mvalancy/pcb-agx-thor-can-breakout/docs/README.md

<!-- generated by tools/write_readmes.py -->
# Engineering documentation

[Project overview](../README.md) · [Documentation](README.md) · [Local design review](http://localhost:8765/site/)

Review the interface, inspect the enclosure, and follow the evidence from source to manufacturing package.

Thor CAN enclosure

## Start with your task

| I want to… | Read this | What it answers |
|---|---|---|
| Verify the wiring | [PINOUT proof](pinout-proof.md) | Original NVIDIA excerpts, J47 pins and termination |
| Set up termination / I/O | [Controls and prototyping](termination-and-io.md) | JP shunts, power rails, FSI GPIO limits and free pad area |
| Understand protection | [Interface and protection](interface-and-protection.md) | TVS selection, open links, raw I/O and electrical limits |
| Inspect the housing | [Enclosure design](enclosure.md) | Lid graphics, keyed seam, inserts, clamp and mating clearances |
| Review the latest changes | [Design review](design-review.md) | Routing, fabrication rules and corrected PCB orientation |
| Prepare a prototype quote | [Manufacturing](manufacturing.md) | Gerbers, two BOM/CPL options and supplier review |
| Decide whether to build 50 | [Release checklist](release-checklist.md) | Tests and procurement evidence still needed |
| Reproduce the work | [Tools guide](../tools/README.md) | Safe export, verification and packaging sequence |

## Evidence and history

[Iteration register](iterations.md) records findings and corrections. [Progress log](progress.md) preserves the development history; its earlier entries describe superseded designs. [Decisions](decisions.yaml) and [milestones](milestones.yaml) feed the local status page.

The current design is **A1, under engineering review**. Native CAD passes do not close physical qualification. A0 downloads are historical and superseded.

<details>
<summary>Complete folder index</summary>

| File or folder | Purpose |
|---|---|
| [img/](img/README.md) | Documentation images |
| [proof/](proof/README.md) | NVIDIA pinout evidence |
| [cad-agent-report.html](cad-agent-report.html) | Project support file |
| [decisions.yaml](decisions.yaml) | Project status/configuration |
| [design-review.md](design-review.md) | Design review — 2026-10-26 |
| [enclosure.md](enclosure.md) | Enclosure design |
| [interface-and-protection.md](interface-and-protection.md) | Interface and protection review |
| [iterations.md](iterations.md) | Iterations and validation evidence |
| [manufacturing.md](manufacturing.md) | Manufacturing and 50-unit plan |
| [milestones.yaml](milestones.yaml) | Project status/configuration |
| [pinout-proof.md](pinout-proof.md) | PINOUT proof |
| [progress.md](progress.md) | Progress log |
| [release-checklist.md](release-checklist.md) | Release checklist |
| [termination-and-io.md](termination-and-io.md) | Termination, power and prototyping |

</details>
