mvalancy/pcb-agx-thor-can-breakout/exports/README.md

<!-- generated by tools/write_readmes.py -->
# Design downloads

[Project overview](../README.md) · [Documentation](../docs/README.md) · [Local design review](http://localhost:8765/site/)

Reviewable electrical packages, printable housing parts and source-bound validation evidence.

Assembled product

## Select your package

| Deliverable | Start here | Contents |
|---|---|---|
| Two-port electronics | [2-port files](2port/README.md) | Native exports, fabrication ZIP, BOM/CPL and reports |
| Four-port electronics | [4-port files](4port/README.md) | Reserved-channel engineering variant |
| Printed housing | Matching `2port_` or `4port_` base/lid | STL, 3MF and STEP; add one common ribbon clamp |
| Fit coupons | [Fastener](fastener_coupon.stl) · [DE9 opening](port_coupon.stl) | Print before committing to a full housing |
| Hardware | [Enclosure BOM](enclosure-bom.csv) | Inserts, screws, silicone pads and mating references |
| Browser assembly | [Viewer data](view/README.md) | Shared cad-agent scenes and downloadable meshes |

Print only the matching base/lid pair plus `ribbon_clamp`. STL and 3MF use print orientation; STEP uses assembly coordinates. `asm_*` files are assembly references, not a print list.

Follow the [assembly guide](../ASSEMBLY.md) and [manufacturing guide](../docs/manufacturing.md). These A1 files are engineering review artifacts; supplier DFM and physical qualification remain open.

<details>
<summary>Complete folder index</summary>

| File or folder | Purpose |
|---|---|
| [2port/](2port/README.md) | 2-port design package |
| [4port/](4port/README.md) | 4-port design package |
| [view/](view/README.md) | Interactive assembly data |
| [2port_base.3mf](2port_base.3mf) | Bed-oriented print mesh and units |
| [2port_base.step](2port_base.step) | Solid model in assembly coordinates |
| [2port_base.stl](2port_base.stl) | Bed-oriented print mesh |
| [2port_lid.3mf](2port_lid.3mf) | Bed-oriented print mesh and units |
| [2port_lid.step](2port_lid.step) | Solid model in assembly coordinates |
| [2port_lid.stl](2port_lid.stl) | Bed-oriented print mesh |
| [4port_base.3mf](4port_base.3mf) | Bed-oriented print mesh and units |
| [4port_base.step](4port_base.step) | Solid model in assembly coordinates |
| [4port_base.stl](4port_base.stl) | Bed-oriented print mesh |
| [4port_lid.3mf](4port_lid.3mf) | Bed-oriented print mesh and units |
| [4port_lid.step](4port_lid.step) | Solid model in assembly coordinates |
| [4port_lid.stl](4port_lid.stl) | Bed-oriented print mesh |
| [asm_2port_can_cables.step](asm_2port_can_cables.step) | Solid model in assembly coordinates |
| [asm_2port_clamp.step](asm_2port_clamp.step) | Solid model in assembly coordinates |
| [asm_2port_female.step](asm_2port_female.step) | Solid model in assembly coordinates |
| [asm_2port_header.step](asm_2port_header.step) | Solid model in assembly coordinates |
| [asm_2port_hoods.step](asm_2port_hoods.step) | Solid model in assembly coordinates |
| [asm_2port_inserts.step](asm_2port_inserts.step) | Solid model in assembly coordinates |
| [asm_2port_legend_paint.step](asm_2port_legend_paint.step) | Solid model in assembly coordinates |
| [asm_2port_pcb.step](asm_2port_pcb.step) | Solid model in assembly coordinates |
| [asm_2port_ribbon.step](asm_2port_ribbon.step) | Solid model in assembly coordinates |
| [asm_2port_screws.step](asm_2port_screws.step) | Solid model in assembly coordinates |
| [asm_2port_thumbscrews.step](asm_2port_thumbscrews.step) | Solid model in assembly coordinates |
| [asm_4port_can_cables.step](asm_4port_can_cables.step) | Solid model in assembly coordinates |
| [asm_4port_clamp.step](asm_4port_clamp.step) | Solid model in assembly coordinates |
| [asm_4port_female.step](asm_4port_female.step) | Solid model in assembly coordinates |
| [asm_4port_header.step](asm_4port_header.step) | Solid model in assembly coordinates |
| [asm_4port_hoods.step](asm_4port_hoods.step) | Solid model in assembly coordinates |
| [asm_4port_inserts.step](asm_4port_inserts.step) | Solid model in assembly coordinates |
| [asm_4port_legend_paint.step](asm_4port_legend_paint.step) | Solid model in assembly coordinates |
| [asm_4port_pcb.step](asm_4port_pcb.step) | Solid model in assembly coordinates |
| [asm_4port_ribbon.step](asm_4port_ribbon.step) | Solid model in assembly coordinates |
| [asm_4port_screws.step](asm_4port_screws.step) | Solid model in assembly coordinates |
| [asm_4port_thumbscrews.step](asm_4port_thumbscrews.step) | Solid model in assembly coordinates |
| [cad-agent-results.json](cad-agent-results.json) | Machine-readable design evidence |
| [designs.json](designs.json) | Machine-readable design evidence |
| [enclosure-bom.csv](enclosure-bom.csv) | Assembly or sourcing table |
| [fastener_coupon.3mf](fastener_coupon.3mf) | Bed-oriented print mesh and units |
| [fastener_coupon.step](fastener_coupon.step) | Solid model in assembly coordinates |
| [fastener_coupon.stl](fastener_coupon.stl) | Bed-oriented print mesh |
| [geometry-checks.json](geometry-checks.json) | Printable solid and mesh evidence |
| [hole-checks.json](hole-checks.json) | Every hole and countersink clear of material, bound to each STEP |
| [inserts.json](inserts.json) | M3 heat-set insert joints: capacities and torque ceiling |
| [overhang-screen.json](overhang-screen.json) | Downward-facing regions flatter than the overhang limit |
| [pcb-agx-thor-can-breakout-plates.3mf](pcb-agx-thor-can-breakout-plates.3mf) | Bed-oriented print mesh and units |
| [pcb-agx-thor-can-breakout-plates.json](pcb-agx-thor-can-breakout-plates.json) | Machine-readable design evidence |
| [pcb-agx-thor-can-breakout-plates.svg](pcb-agx-thor-can-breakout-plates.svg) | Scalable drawing |
| [port_coupon.3mf](port_coupon.3mf) | Bed-oriented print mesh and units |
| [port_coupon.step](port_coupon.step) | Solid model in assembly coordinates |
| [port_coupon.stl](port_coupon.stl) | Bed-oriented print mesh |
| [review.json](review.json) | Machine-readable design evidence |
| [ribbon_clamp.3mf](ribbon_clamp.3mf) | Bed-oriented print mesh and units |
| [ribbon_clamp.step](ribbon_clamp.step) | Solid model in assembly coordinates |
| [ribbon_clamp.stl](ribbon_clamp.stl) | Bed-oriented print mesh |
| [slice-report.json](slice-report.json) | Shared cad-agent slicing estimates and 3MF hashes for every printed part |

</details>
