mvalancy/pcb-agx-thor-can-breakout/tools/README.md

<!-- generated by tools/write_readmes.py -->
# Build and validation tools

[Project overview](../README.md) · [Documentation](../docs/README.md) · [Local design review](http://localhost:8765/site/)

Reproduce the committed design without silently replacing the reviewed routing.

## Rebuild the committed boards

Run from the repository root. `kicad-cli` must be on PATH. The commands marked `KiCad-Python` require the interpreter that provides `pcbnew`; the project venv supplies CadQuery and cad-agent.

```bash
.venv/bin/python tools/export_review.py
KiCad-Python tools/check_can_routing.py
KiCad-Python tools/check_fabrication.py
KiCad-Python tools/check_prototype.py
.venv/bin/python tools/check_electronics.py
.venv/bin/python cad/build.py
.venv/bin/python tools/check_mechanics.py
.venv/bin/python tools/check_lid_markings.py
.venv/bin/python tools/render_review.py
.venv/bin/python tools/draw_mechanics.py
.venv/bin/python tools/draw_controls.py
.venv/bin/cad-agent export-3mf
.venv/bin/cad-agent slice
.venv/bin/python tools/check_lid_slicing.py
.venv/bin/cad-agent view
.venv/bin/python tools/update_evidence.py
.venv/bin/cad-agent report
.venv/bin/python tools/write_readmes.py
.venv/bin/python tools/validate_release.py --record
.venv/bin/python tools/package_release.py
```

`KiCad-Python` above is a placeholder for your KiCad Python executable, not an installed command. Native exports refill and save the board before generating reports. Complete source-changing steps before recording hashes. For a schematic drawing-only adjustment, `export_review.py --schematic-only` regenerates ERC/PDF/netlist and checks parity without changing the board or its STEP.

## Recheck the slicing and printability

With Bambu Studio installed, run `.venv/bin/cad-agent slice`, followed by `.venv/bin/python tools/check_lid_slicing.py`. The shared slicer resolves preset inheritance, runs the offline slices and binds the report to the 3MF hashes. `cad-agent.yaml` lists all seven printed parts (both lids and bases, the ribbon clamp and both coupons), so `exports/slice-report.json` holds a slice, mass and time for each. The project checker then verifies the lids' effective P1S/PETG/nozzle/layer settings and adds actual first-layer SVGs. Vendor presets, sliced projects and G-code stay in ignored `build/slicer/`; no printer is contacted. A successful slice is not a print qualification.

Before a release, also run `.venv/bin/cad-agent holes` (every hole and countersink in each STEP is clear of material: `exports/hole-checks.json`), `.venv/bin/cad-agent overhangs` (downward faces flatter than the limit: `exports/overhang-screen.json`) and `.venv/bin/cad-agent inserts cad/joints.yaml --output exports/inserts.json` (torque ceiling for the M3 insert joints).

## When changing the circuit or routing

`build_electronics.py` overwrites native layouts unless passed `--schematic-only`. Full regeneration includes `update_layout_features.py` for board outline, prototype grids and legends. Export the schematic netlist, then use paired CAN seeds (`route_can_pairs.py`), auxiliary routing (`route_boards.py`), net/zone finalization (`finalize_board.py`), and every electrical check. Read their module documentation before invoking them. Never accept a router exit code as connectivity proof.

| Check | Evidence |
|---|---|
| Native ERC/DRC and parity | KiCad report JSON, including unconnected items |
| `check_electronics.py` | Independent 26-pin source transcription, DE9/TVS/links and BOM/CPL |
| `check_can_routing.py` | H/L path, pair gap, skew, TVS placement and sampled return plane |
| `check_fabrication.py` | JLC-derived feature limits and deliberate native-rule negative control |
| `check_prototype.py` | Isolated pad count/pitch, ribbon exclusion, gated power mapping and bare-pad assembly exclusions |
| `check_mechanics.py` | Assembly insertion paths from exported solids |
| `check_lid_markings.py` | Native glyph-to-artwork, roof edge and counterbore clearances |
| `check_lid_slicing.py` | Offline lid-only Bambu slicing and actual first-layer toolpath proofs |
| `validate_release.py` | Fresh hashes, source reports, printable meshes, 3MF and local links |

Shared geometry, panel markings, routing analysis, reports, site navigation and 3D viewing come from the pinned **cad-agent** dependency. Project scripts hold only Thor-specific dimensions, mapping and workflow. No automated check establishes physical fit, EMC or a supported bitrate.

<details>
<summary>Complete folder index</summary>

| File or folder | Purpose |
|---|---|
| [apply_fab_rules.py](apply_fab_rules.py) | Generation or validation tool |
| [build_electronics.py](build_electronics.py) | Generation or validation tool |
| [check_can_routing.py](check_can_routing.py) | Generation or validation tool |
| [check_electronics.py](check_electronics.py) | Generation or validation tool |
| [check_fabrication.py](check_fabrication.py) | Generation or validation tool |
| [check_lid_markings.py](check_lid_markings.py) | Generation or validation tool |
| [check_lid_slicing.py](check_lid_slicing.py) | Generation or validation tool |
| [check_mechanics.py](check_mechanics.py) | Generation or validation tool |
| [check_prototype.py](check_prototype.py) | Generation or validation tool |
| [draw_controls.py](draw_controls.py) | Generation or validation tool |
| [draw_mechanics.py](draw_mechanics.py) | Generation or validation tool |
| [export_review.py](export_review.py) | Generation or validation tool |
| [finalize_board.py](finalize_board.py) | Generation or validation tool |
| [package_release.py](package_release.py) | Generation or validation tool |
| [render_review.py](render_review.py) | Generation or validation tool |
| [route_boards.py](route_boards.py) | Generation or validation tool |
| [route_can_pairs.py](route_can_pairs.py) | Generation or validation tool |
| [update_evidence.py](update_evidence.py) | Generation or validation tool |
| [update_layout_features.py](update_layout_features.py) | Generation or validation tool |
| [validate_release.py](validate_release.py) | Generation or validation tool |
| [write_readmes.py](write_readmes.py) | Generation or validation tool |

</details>
