mvalancy/pcb-agx-thor-can-breakout/research/README.md

<!-- generated by tools/write_readmes.py -->
# Source investigations

[Project overview](../README.md) · [Documentation](../docs/README.md) · [Local design review](http://localhost:8765/site/)

Manufacturer and carrier evidence behind the selected parts, with unresolved assumptions kept visible.

## Read by decision

| Investigation | Decision supported |
|---|---|
| [J47 footprint audit](j47-footprint-audit.md) | Exact Wieson MPN, native lands and pin numbering |
| [Connector sourcing](connector-sourcing.md) | Ribbon candidate, DE9 and JLC/LCSC selections |
| [Mating DE9 clearance](mating-dsub-clearance.md) | Female connector, backshell and thumbscrew envelopes |
| [Enclosure hardware](enclosure-hardware.md) | Insert, counterbore and clamp hardware selection |
| [IGX compatibility](igx-compatibility.md) | Why extra AURIX net names do not prove carrier support |

Measurement JSON files preserve dimensions used by the builders. [Source register](../references/sources.json) records URLs and hashes; [PINOUT proof](../docs/pinout-proof.md) provides readable source excerpts. Received-part measurement and an exact carrier population audit remain separate requirements.

<details>
<summary>Complete folder index</summary>

| File or folder | Purpose |
|---|---|
| [connector-sourcing.md](connector-sourcing.md) | Connector sourcing and footprint audit |
| [enclosure-hardware.md](enclosure-hardware.md) | Enclosure hardware evidence |
| [igx-compatibility.md](igx-compatibility.md) | Thor CAN carrier compatibility |
| [j47-footprint-audit.md](j47-footprint-audit.md) | J47 Wieson land-pattern audit |
| [j47-footprint-measurements.json](j47-footprint-measurements.json) | Machine-readable design evidence |
| [mating-dsub-clearance.md](mating-dsub-clearance.md) | Mating DE9 connector, hood and screw clearances |
| [mating-dsub-measurements.json](mating-dsub-measurements.json) | Machine-readable design evidence |
| [ribbon-clamp-snaps.json](ribbon-clamp-snaps.json) | Ribbon-clamp snap sizing result |
| [ribbon-clamp-snaps.yaml](ribbon-clamp-snaps.yaml) | Ribbon-clamp snap candidates for cad-agent snapfit |

</details>
