mvalancy/pcb-agx-thor-can-breakout/hardware/2port/README.md

<!-- generated by tools/write_readmes.py -->
# 2-port KiCad project

[Project overview](../../README.md) · [Documentation](../../docs/README.md) · [Local design review](http://localhost:8765/site/)

Native source for the documented AGX Thor FSI CAN0/CAN1 interface.

[Open in KiCad](thor-2port.kicad_pro) · [Schematic PDF](../../exports/2port/schematic.pdf) · [Review exports](../../exports/2port/README.md)

Paired CAN routing

The project includes the schematic, routed board, local symbol/footprint tables and native fabrication rules. `evidence-manifest.json` binds checks to these sources. Review the [pinout proof](../../docs/pinout-proof.md) and [protection scope](../../docs/interface-and-protection.md) before modifying the interface.

CAN trunks use 0.25 mm copper with 0.25 mm straight-section spacing and a protected bottom return corridor. This two-layer/ribbon assembly is not controlled 120 Ω impedance or qualified for a maximum data rate. All removable links are open by default.

<details>
<summary>Complete folder index</summary>

| File or folder | Purpose |
|---|---|
| [Thor.kicad_sym](Thor.kicad_sym) | Pinned schematic symbols |
| [evidence-manifest.json](evidence-manifest.json) | Machine-readable design evidence |
| [fp-lib-table](fp-lib-table) | Project support file |
| [sym-lib-table](sym-lib-table) | Project support file |
| [thor-2port.kicad_dru](thor-2port.kicad_dru) | Native fabrication rules |
| [thor-2port.kicad_pcb](thor-2port.kicad_pcb) | Routed native board |
| [thor-2port.kicad_pro](thor-2port.kicad_pro) | KiCad project settings |
| [thor-2port.kicad_sch](thor-2port.kicad_sch) | Native schematic |

</details>
