mvalancy/pcb-agx-thor-can-breakout/.agents/inbox/README.md

<!-- generated by tools/write_readmes.py -->
# Incident records

[Project overview](../../README.md) · [Documentation](../../docs/README.md) · [Local design review](http://localhost:8765/site/)

Dated findings, preserved with their command evidence and corrective rules.

Use these records to understand why a guard or design constraint exists. Start at the [symptom index](../SYMPTOM-INDEX.md); curate durable facts and repeatable procedures without discarding the original evidence.

<details>
<summary>Complete folder index</summary>

| File or folder | Purpose |
|---|---|
| [2026-10-26-can-routing-is-not-connectivity.md](2026-10-26-can-routing-is-not-connectivity.md) | A clean connectivity DRC does not establish differential routing or return continuity |
| [2026-10-26-complete-kicad-evidence.md](2026-10-26-complete-kicad-evidence.md) | Run every KiCad severity and enable default-disabled checks before accepting a clean report |
| [2026-10-26-github-readme-precedence.md](2026-10-26-github-readme-precedence.md) | A generic .github README overrides the repository's project overview |
| [2026-10-26-ground-islands-need-a-real-bridge.md](2026-10-26-ground-islands-need-a-real-bridge.md) | Stitching vias must join distinct ground regions, not the same isolated island |
| [2026-10-26-preserve-pcb-handedness.md](2026-10-26-preserve-pcb-handedness.md) | Align a PCB STEP with a proper rotation, never a reflection |
| [2026-10-26-prototype-power-and-supports.md](2026-10-26-prototype-power-and-supports.md) | Verify new power taps and post-cut structural webs independently |
| [2026-10-26-release-manifest-allowlist.md](2026-10-26-release-manifest-allowlist.md) | Package the validated public manifest, not every file beside a design |
| [2026-10-26-report-freshness-formats.md](2026-10-26-report-freshness-formats.md) | Check each report's declared evidence rather than assuming one report schema |
| [2026-10-26-review-export-readbacks.md](2026-10-26-review-export-readbacks.md) | Render the exported assembly readback to check the deliverable |
| [2026-10-26-tangent-boss-mesh.md](2026-10-26-tangent-boss-mesh.md) | Valid CAD can hide non-manifold tangent boss contacts |
| [2026-10-26-thor-hardware-validation.md](2026-10-26-thor-hardware-validation.md) | Verify exact footprints and real cable clearance after every design substitution |
| [2026-10-27-four-corner-mounts.md](2026-10-27-four-corner-mounts.md) | Spread mounting loads with broad roots at the corners, not thickness alone |
| [2026-10-27-printable-lid-markings.md](2026-10-27-printable-lid-markings.md) | Check engraving at nozzle scale, not only in a paint-filled render |
| [2026-11-03-hash-moved-modules-not-shims.md](2026-11-03-hash-moved-modules-not-shims.md) | Hash the module that holds the code, not the shim left at its old import path |

</details>
