mvalancy/pcb-agx-thor-can-breakout/.agents/domains/README.md

<!-- generated by tools/write_readmes.py -->
# Engineering facts

[Project overview](../../README.md) · [Documentation](../../docs/README.md) · [Local design review](http://localhost:8765/site/)

Durable facts with explicit source and scope.

[Thor interface](thor-interface.md) summarizes the bus-side connector, protection boundaries and carrier compatibility limits. Cross-check against the current [source proof](../../docs/pinout-proof.md) before changing pin mappings.

<details>
<summary>Complete folder index</summary>

| File or folder | Purpose |
|---|---|
| [thor-interface.md](thor-interface.md) | Thor J47 authority |

</details>
