mvalancy/pcb-agx-thor-can-breakout/docs/proof/README.md

<!-- generated by tools/write_readmes.py -->
# NVIDIA pinout evidence

[Project overview](../../README.md) · [Documentation](../README.md) · [Local design review](http://localhost:8765/site/)

Small source excerpts for direct review of the J47 connector and the supported Thor CAN pins.

[Read the annotated PINOUT proof](../pinout-proof.md) for the cross-check, source revisions and limits.

| Image | Source |
|---|---|
| [Full J47 connector](nvidia-p4071-a02-j47.png) | NVIDIA P4071 A02 concept schematic, sheet 11 |
| [Supported FSI pins](nvidia-r38-2-thor-can.png) | NVIDIA Jetson Linux Developer Guide, r38.2, CAN table, Thor column |

[provenance.json](provenance.json) records the original document hash, crop coordinates, URL and capture date. The images are source excerpts, not redrawn project diagrams. © NVIDIA; excluded from the project's MIT grant. Full vendor documents are not redistributed.

<details>
<summary>Complete folder index</summary>

| File or folder | Purpose |
|---|---|
| [nvidia-p4071-a02-j47.png](nvidia-p4071-a02-j47.png) | Rendered design evidence |
| [nvidia-r38-2-thor-can.png](nvidia-r38-2-thor-can.png) | Rendered design evidence |
| [provenance.json](provenance.json) | Source capture coordinates, dates and hashes |

</details>
