mvalancy/pcb-agx-thor-can-breakout/exports/view/README.md

<!-- generated by tools/write_readmes.py -->
# Interactive assembly data

[Project overview](../../README.md) · [Documentation](../../docs/README.md) · [Local design review](http://localhost:8765/site/)

Scene and mesh assets generated by the shared cad-agent viewer.

Open the [local 3D viewer](http://localhost:8765/_cadagent/kit/viewer.html) or the embedded model in the [design review page](http://localhost:8765/site/#design-review).

Each variant includes the housing, native PCB, ribbon, clamp, hardware, mating connectors and optional legend paint. Use the part controls, explode slider and section tools to inspect the assembly. Regenerate with `.venv/bin/cad-agent view` after all STEP exports and readback checks finish.

These JSON/mesh files are browser assets. Use [STL/3MF](../README.md) for printing and [native KiCad](../../hardware/README.md) for electrical edits.

<details>
<summary>Complete folder index</summary>

| File or folder | Purpose |
|---|---|
| [2port.json](2port.json) | Machine-readable design evidence |
| [2port_base.stl](2port_base.stl) | Bed-oriented print mesh |
| [2port_can_cables.stl](2port_can_cables.stl) | Bed-oriented print mesh |
| [2port_clamp.stl](2port_clamp.stl) | Bed-oriented print mesh |
| [2port_female.stl](2port_female.stl) | Bed-oriented print mesh |
| [2port_header.stl](2port_header.stl) | Bed-oriented print mesh |
| [2port_hoods.stl](2port_hoods.stl) | Bed-oriented print mesh |
| [2port_inserts.stl](2port_inserts.stl) | Bed-oriented print mesh |
| [2port_legend_paint.stl](2port_legend_paint.stl) | Bed-oriented print mesh |
| [2port_lid.stl](2port_lid.stl) | Bed-oriented print mesh |
| [2port_pcb.stl](2port_pcb.stl) | Bed-oriented print mesh |
| [2port_ribbon.stl](2port_ribbon.stl) | Bed-oriented print mesh |
| [2port_screws.stl](2port_screws.stl) | Bed-oriented print mesh |
| [2port_thumbscrews.stl](2port_thumbscrews.stl) | Bed-oriented print mesh |
| [4port.json](4port.json) | Machine-readable design evidence |
| [4port_base.stl](4port_base.stl) | Bed-oriented print mesh |
| [4port_can_cables.stl](4port_can_cables.stl) | Bed-oriented print mesh |
| [4port_clamp.stl](4port_clamp.stl) | Bed-oriented print mesh |
| [4port_female.stl](4port_female.stl) | Bed-oriented print mesh |
| [4port_header.stl](4port_header.stl) | Bed-oriented print mesh |
| [4port_hoods.stl](4port_hoods.stl) | Bed-oriented print mesh |
| [4port_inserts.stl](4port_inserts.stl) | Bed-oriented print mesh |
| [4port_legend_paint.stl](4port_legend_paint.stl) | Bed-oriented print mesh |
| [4port_lid.stl](4port_lid.stl) | Bed-oriented print mesh |
| [4port_pcb.stl](4port_pcb.stl) | Bed-oriented print mesh |
| [4port_ribbon.stl](4port_ribbon.stl) | Bed-oriented print mesh |
| [4port_screws.stl](4port_screws.stl) | Bed-oriented print mesh |
| [4port_thumbscrews.stl](4port_thumbscrews.stl) | Bed-oriented print mesh |
| [fastener_coupon.stl](fastener_coupon.stl) | Bed-oriented print mesh |
| [port_coupon.stl](port_coupon.stl) | Bed-oriented print mesh |
| [ribbon_clamp.stl](ribbon_clamp.stl) | Bed-oriented print mesh |
| [view.json](view.json) | Machine-readable design evidence |

</details>
