mvalancy/pcb-agx-thor-can-breakout/docs/enclosure.md

# Enclosure design

A keyed, screw-fastened housing with a separate padded ribbon clamp and enough port spacing for mating DE9 backshells. Both variants share the same seam, hardware and graphical lid language.

Assembled two-port housing with mating connectors

## Lid and port identity

Engraved male DE9 pinout and port badges

The roof carries a numbered **male mating-face** DE9 diagram, CAN-H/L, ground and shield callouts, unconnected pins, port badges, revision and `github.com/mvalancy`. All lettering is bold: body text uses a 4 mm font size, pin numbers 4.2 mm and port badges 5.2 mm. The nameplate uses 8.5 mm THOR and 6.5 mm CAN lettering. These are font em sizes; actual glyph heights vary. All graphic lines, rings and arrows are 1 mm wide. Notes are split across lines and the larger numbered diagram leaves room around the heavier text.

Recessed markings are 0.4 mm deep in a 2.4 mm roof, leaving 2.0 mm beneath the engraving. Light paint fill is optional. The same shared cad-agent vector primitive generates the engraving, paint reference and [SVG proof](../preview/2port-lid-artwork.svg). The [two-port](../exports/2port/lid-markings-review.json) and [four-port](../exports/4port/lid-markings-review.json) checks measure native glyph-to-artwork, roof-edge and screw-counterbore distances against a 0.6 mm clearance floor. Graphic stroke width is not a minimum font-stroke claim; print legibility still needs a physical sample.

Port badges follow the physical PCB orientation. CAN0 is at the right in the housing's top/front coordinate view; the native KiCad PCB view has the opposite X direction after a proper assembly rotation. The four-port model labels its extra channels **RES2 / RES3**.

Actual sliced first layer, viewed from the outside reading face

The offline slicing checks use Bambu Studio 02.08.04.57 with a P1S 0.4 mm nozzle, PETG, 0.2 mm layers, four walls and 30% infill. The first-layer proof is drawn from extrusion paths, including their recorded widths. No printer was contacted. These checks support layout review; tiny enclosed letter islands, bed adhesion and final legibility still need a printed sample. [Two-port slicing report](../exports/2port/lid-slicing-review.json) · [Four-port slicing report](../exports/4port/lid-slicing-review.json).

All seven printed parts are sliced with those settings and supports off ([slice report](../exports/slice-report.json)): 295 g of PETG and about 9.9 h for one of each. The two-port lid is 46.9 g (108 min), the four-port lid 74.2 g (153 min), the bases 66.5 g and 97.2 g, the clamp 2.5 g and the coupons 6.8 g and 1.1 g. The [overhang screen](../exports/overhang-screen.json) lists three kinds of flat downward face, all printed without supports. The underside of each base's clamp deck (389 mm² at Z 11.6 mm, over the ribbon channel) and the roofs of the lids' 0.4 mm engraving pockets (which face the bed, because the lids print roof-down) are printed by the slicer as bridges. The floors of the four lid counterbores (4 × 23 mm² at print Z 3.3 mm, 1.5 mm-wide rings under the screw heads) are printed as overhanging walls. None of these has been printed yet. The [hole check](../exports/hole-checks.json) finds every hole clear. The lids' 18 engraved pin-number rings are listed as exceptions in `cad-agent.yaml`, because a ring around a numeral reads as a hole with material inside.

## Serviceable mechanical details

Exploded housing

| Feature | Nominal design |
|---|---|
| Port spacing | 42 mm centers; 9.8 mm plastic rib between openings |
| Mating clearance | 7.7 mm between maximum-width modeled backshells |
| Keyed seam | 2.0 mm tongue width, 1.6 mm height, 0.25 mm clearance |
| Lid hardware | Four M3 × 20 screws, heat-set inserts, Ø6.4 × 3.3 mm counterbores |
| Ribbon clamp | Replaceable bar, two M3 × 6 screws and heat-set inserts |
| Cable contact | Two 0.8 mm silicone pads; 1.8 mm hard-stop gap |
| Lid screw bosses | Ø10.6 mm; 2.1 mm radial web around Ø6.4 counterbores |
| Wall and seam root | 4.5 mm wall; 2.25 mm remaining outside the groove |
| Rear clamp support | Two 3.2 mm ribs, R1.6 wall roots, positive floor/wall overlap |
| Side mounting | Four Ø3.4 M3 holes; Ø6.4 × 3.3 counterbores; 26 mm-wide, 7 mm-thick ears; R4 roots |
| Pilot selection | Print the 3.8 / 3.9 / 4.0 mm insert coupon first |

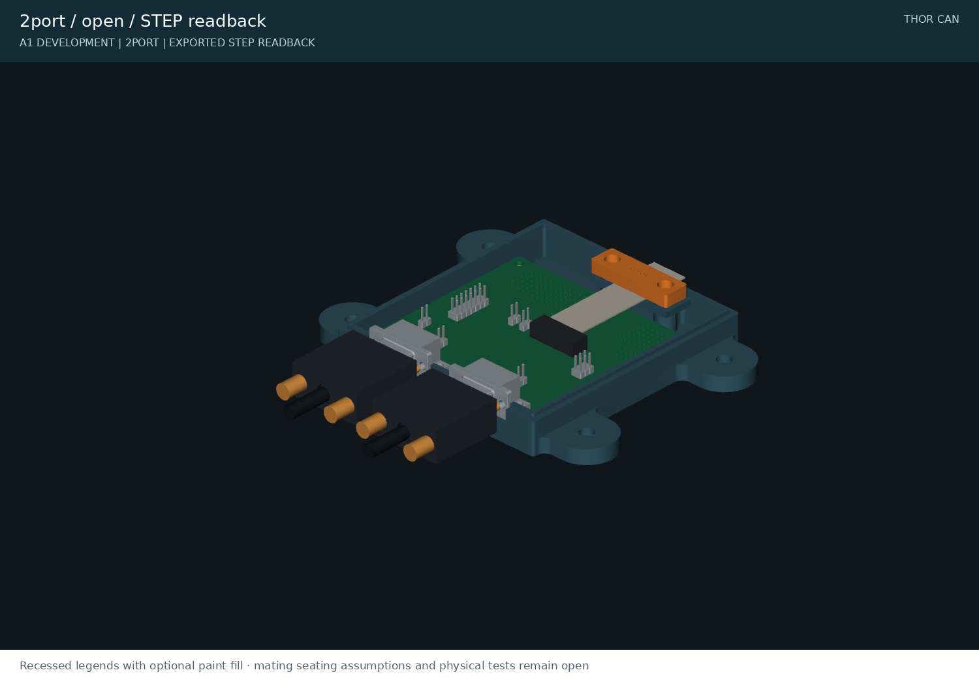
[picture p8: preview/2port-open.png]
Open assembly and ribbon retention


The mating references include Assmann A-DF 09 LL/Z female connectors, A-FT 09 backshells, #4-40 thumbscrews and cable envelopes. Their dimensions come from drawings; hood capture and screw engagement require physical samples. [Mating audit](../research/mating-dsub-clearance.md).

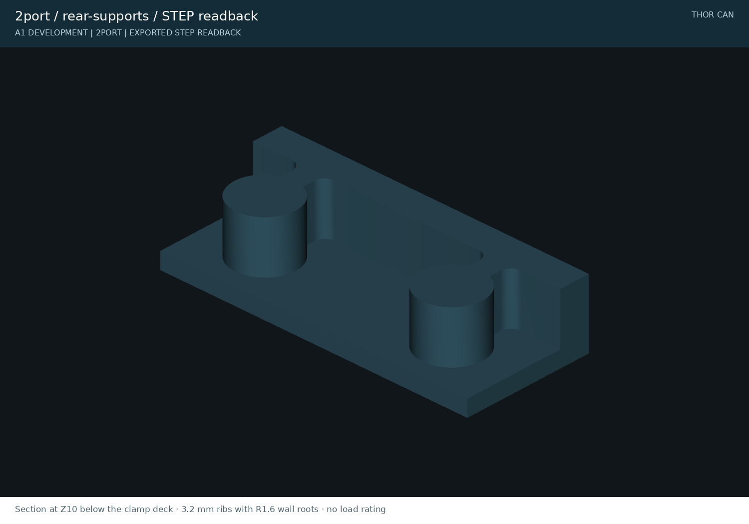
[picture p9: preview/2port-rear-supports.png]
Section below the clamp deck showing filleted rear insert supports


The section cuts the exported base at Z10 to expose the supports beneath the clamp deck. It shows the actual load-path geometry used in the printable part.

The six exploded screws are four **M3 × 20 lid screws** and two **M3 × 6 clamp screws**; all six engage heat-set inserts. There are no self-tapping screws in this version. The 40 × 12 mm clamp leaves 2.8 mm of plastic at the closest counterbore edge. The modeled structural webs are at least 2 mm, including 2.1 mm at lid counterbores, 2.3 mm under clamp counterbores and 2.0 mm under engraved roof strokes; recessed artwork intentionally uses finer cosmetic strokes. These dimensions improve the load path but are not a printed strength rating. The [insert screen](../exports/inserts.json) (`cad-agent inserts cad/joints.yaml`) puts the jack-out torque ceiling for both the lid and clamp joints at **0.14 N·m**: drive these screws by hand and stop at first firm contact. Washers do not help: with an ISO 7089 or 7093 washer under the head the ceiling falls to 0.092 N·m, because the washer's lower friction reaches the jack-out preload at less torque. Setting the inserts flush would raise it only to about 0.17 N·m (0.22 N·m with a washer on the insert face), so the recessed inserts stay, and the coupon test sets the real limit. The same screen warns that the clamp bosses (Ø9.2 mm, 2.5 mm wall) are above the makers' minimum but under their full-performance Ø9.4 mm. It also advises printing insert bosses solid (7 perimeters), while the slice profile uses 4 walls and 30 % infill. Print the coupon both ways before choosing. A snap-fit clamp was screened and rejected ([snap screen](../research/ribbon-clamp-snaps.json)). The 10 mm arms strain past PETG's limit. A 14 mm arm passes, but with only about 5 % strain margin, where about 50 % is recommended.

The four mounting ears belong to the base, two near the corners of each connector-free side. Each is **26 mm wide**, with an **R4 root** spreading to **34 mm at the wall**, while thickness remains **7 mm**. The outer edge leaves 9.8 mm of plastic around the counterbore. Their centers are 10 mm outside the side walls at Y14 and Y90, keeping the front connectors and rear ribbon path clear. Four M3 holes form a **123.2 × 76 mm** pattern on the two-port base or **207.2 × 76 mm** on the four-port base.

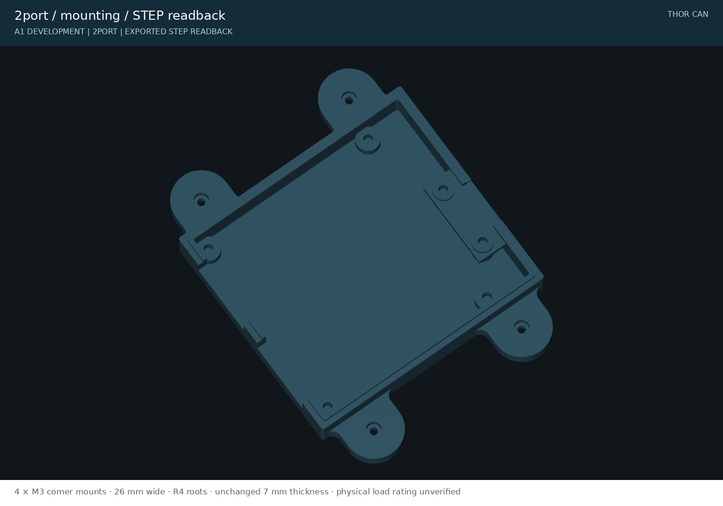
[picture p10: preview/2port-mounting.png]
Four broad corner mounting ears and recessed M3 holes


M3 socket heads recess below the tab surface; mounting screw length and receiving nut/thread depend on the installation. Both driver access with the lid fitted and the head/shank clearances are checked at all four holes. The actual fused wall-root sections are also measured. Overall sizes including ears are **149.2 × 114.2 × 26.8 mm** and **233.2 × 114.2 × 26.8 mm**. These are geometry checks, not a printed load rating.

The extended PCB has two prototype regions outside the central ribbon lane. A separate clearance check covers components up to 12 mm above the PCB and leads trimmed to 3 mm below it. [Prototype area and controls](termination-and-io.md).

The preferred cable candidate is now the 152.4 mm Samtec assembly. The larger enclosure consumes approximately 57 mm of straight internal span before bend and strain-relief allowances, so the previous 101.6 mm candidate leaves substantially less external reach. Actual cable routing, connector keying and conductor continuity still need a sample.

## Build and inspect

Use the matching base/lid pair plus one common clamp. [Downloads](../exports/README.md) include STL, STEP and 3MF; [ASSEMBLY.md](../ASSEMBLY.md) gives print orientation, hardware, pads and installation. Print the port and insert coupons first. Target a 10 N / 60 s ribbon pull test with continuity checked before and after; this test has not been performed.

CAD checks cover solid validity, meshes, fastener axial stacks, native PCB collisions and assembly paths. They do not establish plastic creep, insert pull-out, cable retention, exact connector fit or allowable screw torque. A0 housings used an improper mirrored PCB frame and are superseded by A1's proper rotation.

[Two-port dimensions](../exports/2port/enclosure-plan.svg) · [Four-port dimensions](../exports/4port/enclosure-plan.svg) · [Local interactive viewer](http://localhost:8765/_cadagent/kit/viewer.html)
