mvalancy/pcb-agx-thor-can-breakout/docs/release-checklist.md

# Release checklist

**Current designation: A1 engineering pre-release, not production ready.** Source code and design exports can be published now. Ordering the 50-unit run requires the evidence below.

| Gate | Current evidence | Required closure |
|---|---|---|
| AGX interface | A02 original schematic/BOM inspected; J47 map recorded | Confirm actual carrier revision/population |
| Exact requested header | Wieson MPN and native26pad layout cross-checked; defaultJ1 updated | Current Wieson drawing/procurement and physical key/height/pin1 proof |
| Ribbon cable | Exact orderable candidate and manufacturer family data | All26 pin continuity, fit, route and strain test on sample |
| Four-port/IGX | Generic A02 extra channels; IGX MCU research | Exact IGX A04 carrier documents and population; no inferred compatibility |
| Electrical CAD | Native KiCad ERC/DRC/net parity, independent pin mapping, routing and hashes | Latest source-bound reports clean, independent pinout review |
| Protection | Exact Bourns TVS and nominal voltage comparison | Defined ESD/EFT/surge setup, waveforms, survival and communication results |
| Signal integrity | Paired trunks, measured skew/spacing and sampled return plane; no maximum rate qualified | Intended CAN/CAN-FD rates, bus lengths, ribbon, capacitance and error measurements |
| Auxiliary I/O | Raw pins retained, power links open | Voltage/direction/current limits and any needed protection established |
| PCB assembly | JLC-format SMT and full-BOM paths, exact sourced connectors; Gerbers carry revision A1 REVIEW; stock read 2026-11-03: TVS and headers in stock, **Assmann DE9 C3127392 at zero at JLC and LCSC** | DE9 supply (consign, global sourcing or an audited substitute), Wieson J1 consignment, authenticated JLCDFM (no report yet)/panel, placement rotation, first article approval |
| Housing | Valid solids/meshes, native PCB collisions, engraving clearances; all seven printed parts sliced offline (PETG, 295 g, 9.9 h, supports off); every hole clear apart from the lids' engraved pin rings; insert screen gives a 0.14 N·m torque ceiling | Actual print of the bridged clamp deck and lid lettering, flange/plug/header fit, insert pull-out and torque, lid fasteners, hot/creep checks |
| Strain relief | Heat-set inserts, recessed heads, hard stops, replaceable pads and clamp | Actual ribbon thickness;10N/60s pull and continuity before/after dwell |
| Saleable units | Proposed50-unit target | Every-unit continuity/functional test, serial/revision tracking and documented ratings |

Reports may pass CAD checks while these gates remain open. No automated tool is allowed to turn an unmeasured field into a passed physical gate. Prerelease packaging remains enabled until all applicable gates have recorded, reviewable test results.
