mvalancy/pcb-agx-thor-can-breakout/docs/cad-agent-report.html

# AGX Thor CAN breakout · CAD verification

- project: pcb-agx-thor-can-breakout
- revision: rev A1-development
- generated: 2026-11-03 17:28 UTC (last commit)

all pass38 pass0 fail1 skip

CAD verification onlyCAD checks only. They do not verify physical fit, print quality, slicer output, fastener engagement, thermal behaviour or load capacity.

## passPrinted parts7 pass · 0 fail · 0 skip

pass

2port base

valid single solid · watertight · 149.194 × 114.2 × 16.9 mm · fits Bambu P1S / prototype bed 256 × 256 × 256 mm

pass

2port lid

valid single solid · watertight · 103.2 × 114.2 × 17 mm · fits Bambu P1S / prototype bed 256 × 256 × 256 mm

pass

4port base

valid single solid · watertight · 233.194 × 114.2 × 16.9 mm · fits Bambu P1S / prototype bed 256 × 256 × 256 mm

pass

4port lid

valid single solid · watertight · 187.2 × 114.2 × 17 mm · fits Bambu P1S / prototype bed 256 × 256 × 256 mm

pass

ribbon clamp

valid single solid · watertight · 40 × 12 × 5.6 mm · fits Bambu P1S / prototype bed 256 × 256 × 256 mm

pass

fastener coupon

valid single solid · watertight · 44 × 24 × 8 mm · fits Bambu P1S / prototype bed 256 × 256 × 256 mm

pass

port coupon

valid single solid · watertight · 38 × 19 × 3 mm · fits Bambu P1S / prototype bed 256 × 256 × 256 mm

## passPrint files7 pass · 0 fail · 0 skip

pass

2port base

2port_base.3mf

STL + 3MF (print orientation), STEP (assembly)

pass

2port lid

2port_lid.3mf

STL + 3MF (print orientation), STEP (assembly)

pass

4port base

4port_base.3mf

STL + 3MF (print orientation), STEP (assembly)

pass

4port lid

4port_lid.3mf

STL + 3MF (print orientation), STEP (assembly)

pass

ribbon clamp

ribbon_clamp.3mf

STL + 3MF (print orientation), STEP (assembly)

pass

fastener coupon

fastener_coupon.3mf

STL + 3MF (print orientation), STEP (assembly)

pass

port coupon

port_coupon.3mf

STL + 3MF (print orientation), STEP (assembly)

## passHoles clear7 pass · 0 fail · 0 skip

pass

2port base

14 hole(s) clear

pass

2port lid

17 hole(s) clear, 9 listed exception(s)

pass

4port base

14 hole(s) clear

pass

4port lid

17 hole(s) clear, 9 listed exception(s)

pass

ribbon clamp

4 hole(s) clear

pass

fastener coupon

9 hole(s) clear

pass

port coupon

0 hole(s) clear

## passDesign checks17 pass · 0 fail · 0 skip

pass

2port-electrical-review · 2port electrical-review

exports/2port/electrical-review.json

pass true in exports/2port/electrical-review.json

pass

2port-mechanical-checks · 2port mechanical-checks

exports/2port/mechanical-checks.json

pass true in exports/2port/mechanical-checks.json · physical fit not verified

pass

4port-electrical-review · 4port electrical-review

exports/4port/electrical-review.json

pass true in exports/4port/electrical-review.json

pass

4port-mechanical-checks · 4port mechanical-checks

exports/4port/mechanical-checks.json

pass true in exports/4port/mechanical-checks.json · physical fit not verified

pass

2port-paths · 2port assembly paths

exports/2port/assembly-paths.json

pass true in exports/2port/assembly-paths.json · physical fit not verified

pass

4port-paths · 4port assembly paths

exports/4port/assembly-paths.json

pass true in exports/4port/assembly-paths.json · physical fit not verified

pass

2port-can-routing-review · 2port CAN paired routing

exports/2port/can-routing-review.json

pass true in exports/2port/can-routing-review.json

pass

2port-fabrication-profile-check · 2port Local fabrication profile

exports/2port/fabrication-profile-check.json

pass true in exports/2port/fabrication-profile-check.json

pass

4port-can-routing-review · 4port CAN paired routing

exports/4port/can-routing-review.json

pass true in exports/4port/can-routing-review.json

pass

4port-fabrication-profile-check · 4port Local fabrication profile

exports/4port/fabrication-profile-check.json

pass true in exports/4port/fabrication-profile-check.json

pass

2port-prototype · 2port prototype pads and power

exports/2port/prototype-review.json

pass true in exports/2port/prototype-review.json

pass

4port-prototype · 4port prototype pads and power

exports/4port/prototype-review.json

pass true in exports/4port/prototype-review.json

pass

2port-lid-markings · 2port engraved lettering clearances

exports/2port/lid-markings-review.json

pass true in exports/2port/lid-markings-review.json

pass

4port-lid-markings · 4port engraved lettering clearances

exports/4port/lid-markings-review.json

pass true in exports/4port/lid-markings-review.json

pass

2port-lid-slicing · 2port offline lid slicing

exports/2port/lid-slicing-review.json

pass true in exports/2port/lid-slicing-review.json

pass

4port-lid-slicing · 4port offline lid slicing

exports/4port/lid-slicing-review.json

pass true in exports/4port/lid-slicing-review.json

pass

inserts · Heat-set insert joints (cad-agent inserts cad/joints.yaml)

exports/inserts.json

pass true in exports/inserts.json

## skipReview pages and links0 pass · 0 fail · 1 skip

skip

no pages configured

add cad.html_pages to cad-agent.yaml

## Print files

STL and 3MF are in print orientation (3MF centred on the bed); STEP is in assembly coordinates.

| Part | STL | 3MF | STEP | Slicer
no render | 2port base | STL | 3MF | STEP | 3MF (serve over http for Bambu Studio)
no render | 2port lid | STL | 3MF | STEP | 3MF (serve over http for Bambu Studio)
no render | 4port base | STL | 3MF | STEP | 3MF (serve over http for Bambu Studio)
no render | 4port lid | STL | 3MF | STEP | 3MF (serve over http for Bambu Studio)
no render | ribbon clamp | STL | 3MF | STEP | 3MF (serve over http for Bambu Studio)
no render | fastener coupon | STL | 3MF | STEP | 3MF (serve over http for Bambu Studio)
no render | port coupon | STL | 3MF | STEP | 3MF (serve over http for Bambu Studio)

- checks: 38 pass / 0 fail / 1 skip
- physical fit: physical fit NOT verified (CAD only)
- slicer: sliced (Bambu Studio (command line)): 295.1 g, 9.85 h for 7 part(s), 0.20mm Standard @BBL X1C, Generic PETG
