mvalancy/pcb-agx-thor-can-breakout/.agents/playbooks/README.md

<!-- generated by tools/write_readmes.py -->
# Review procedures

[Project overview](../../README.md) · [Documentation](../../docs/README.md) · [Local design review](http://localhost:8765/site/)

Repeatable sequences for regenerating evidence and preparing review packages.

The [release playbook](release.md) covers native checks, STEP readbacks, hashes and package validation. The [tools guide](../../tools/README.md) provides current commands; both must preserve the branch and ownership of unrelated work.

<details>
<summary>Complete folder index</summary>

| File or folder | Purpose |
|---|---|
| [release.md](release.md) | Validate before packaging |

</details>
