mvalancy/pcb-agx-thor-can-breakout/preview/2port_base.png

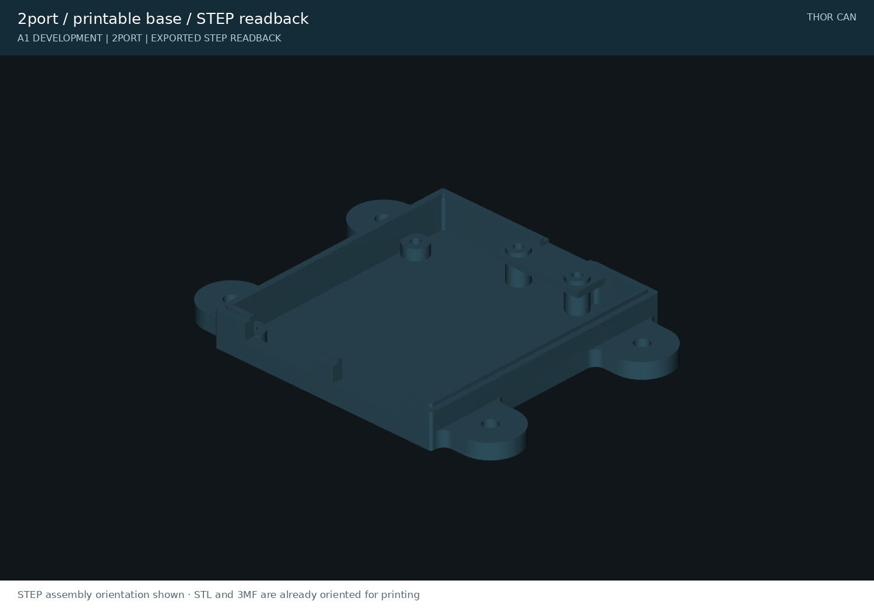
preview/2port_base.png
