mvalancy/pcb-agx-thor-can-breakout/preview/2port_lid.png

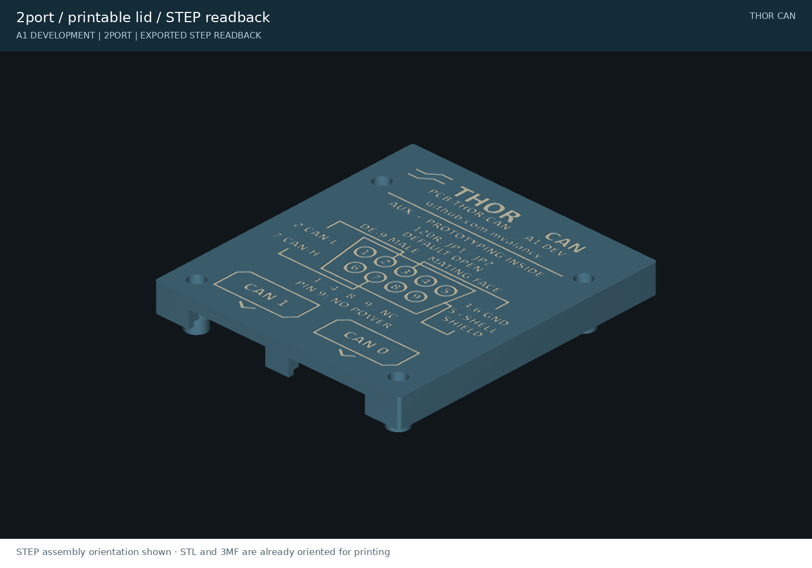
preview/2port_lid.png
