mvalancy/pcb-agx-thor-can-breakout/preview/4port-lid.png

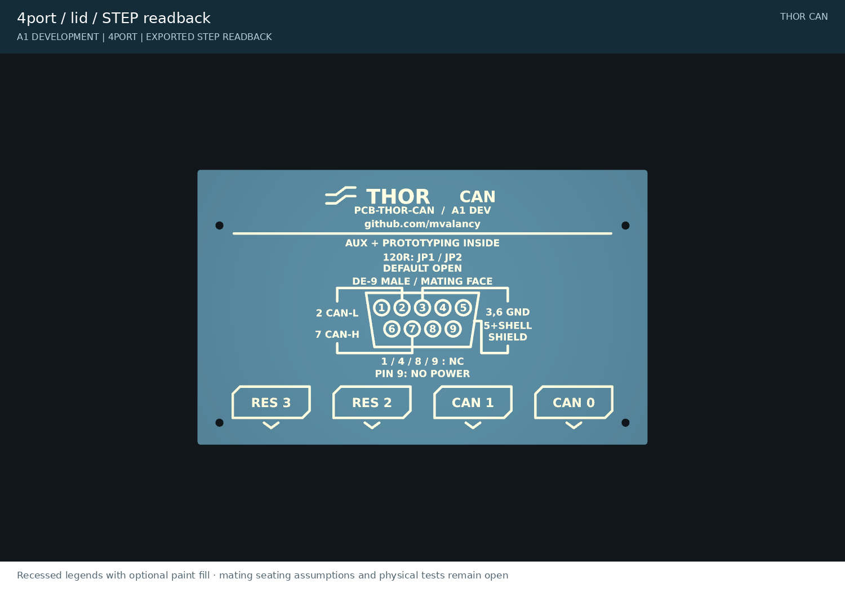
preview/4port-lid.png
