mvalancy/pcb-agx-thor-can-breakout/preview/4port-mounting.png

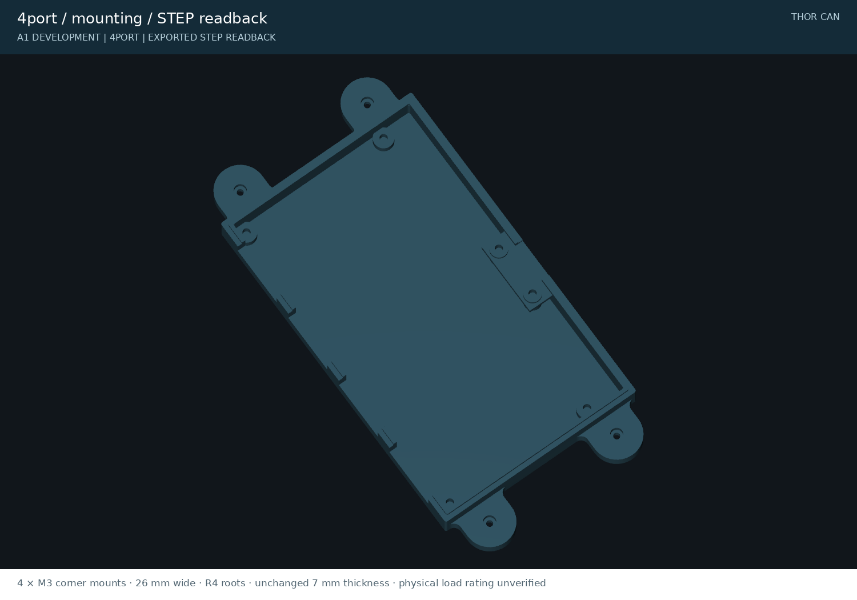
preview/4port-mounting.png
