mvalancy/pcb-agx-thor-can-breakout/preview/4port_base.png

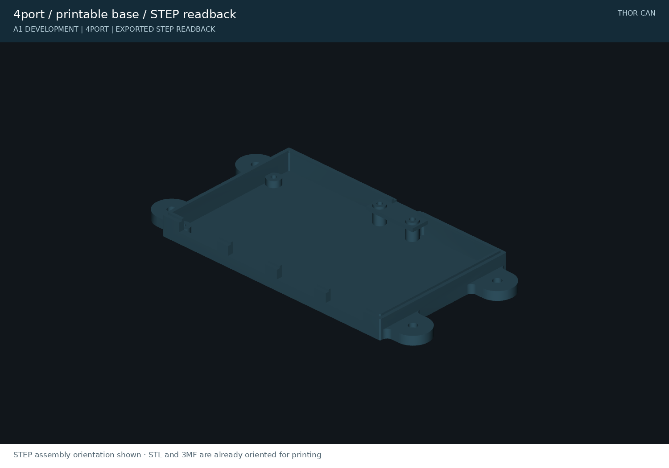
preview/4port_base.png
