mvalancy/pcb-agx-thor-can-breakout/preview/fastener_coupon.png

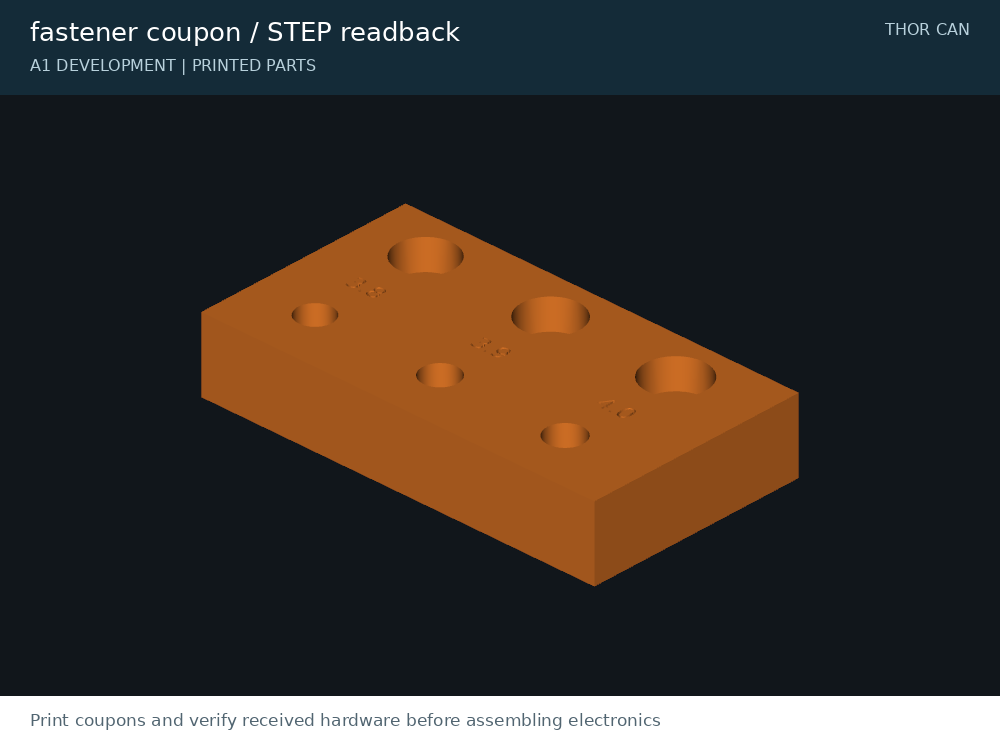
preview/fastener_coupon.png
