mvalancy/pcb-agx-thor-can-breakout/preview/port_coupon.png

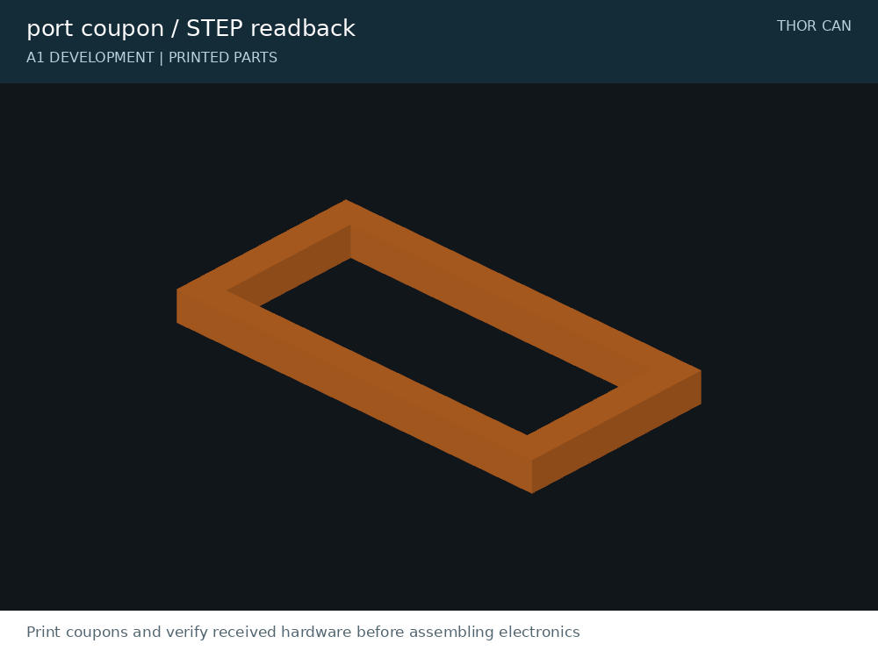
preview/port_coupon.png
