mvalancy/pcb-agx-thor-can-breakout/preview/ribbon_clamp.png

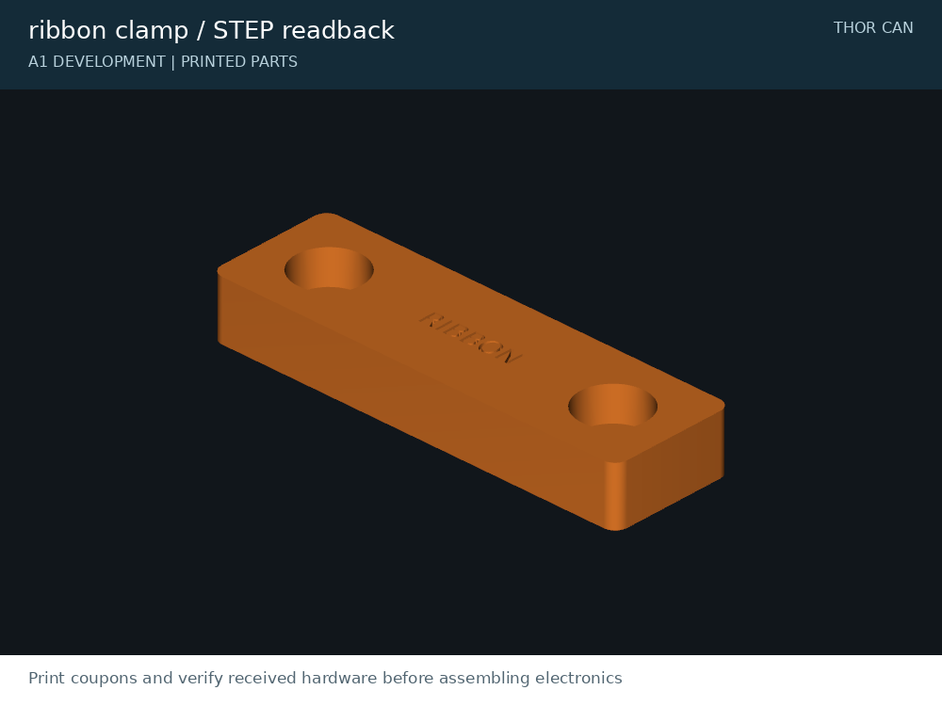
preview/ribbon_clamp.png
