mvalancy/pcb-agx-thor-can-breakout/exports/enclosure-bom.csv

Item | Quantity per enclosure | Specification | Part or reference | Status
Base | 1 | PETG; select matching variant | 2port_base or 4port_base | Print/coupon validation pending
Lid | 1 | PETG; recessed legends; optional paint | 2port_lid or 4port_lid | Print/coupon validation pending
Ribbon clamp | 1 | PETG; 1.8 mm hard gap | ribbon_clamp | Pull/creep validation pending
Heat-set insert | 6 | M3 x 0.5; installed length 4.3 mm | McMaster 94459A130 | Received-part/coupon verification pending
Lid screw | 4 | M3 x 20; socket head diameter 5.5 x height 3 mm | ISO 4762 dimensional requirement | Exact procurement SKU pending
Clamp screw | 2 | M3 x 6; socket head diameter 5.5 x height 3 mm | McMaster 91292A111 candidate | Current catalog/stock recheck required
PCB washer | 4 | Silicone foam OD7/ID3.4 x 1 mm | Cut to size | Compression/creep qualification pending
Ribbon pad | 2 | Adhesive silicone foam 18 x 6 x 0.8 mm | Cut to size | Cable adhesive/compression qualification pending
Ribbon assembly | 1 | 26 positions; 152.4 mm; female/female | Samtec FFSD-13-D-06.00-01-N | Thor mating and 26-pin continuity pending
Female demonstration connector | 2 or 4 | DE9 female solder cup | Assmann A-DF 09 LL/Z / AE11063-ND | Physical mate unverified
Demonstration hood | 2 or 4 | Hinged hood with two 4-40 thumbscrews | Assmann A-FT 09 / AE11002-ND | Capture/engagement unverified
Jumper cap | 5 (2port) / 7 (4port) | 2.54 mm two-position removable shunt | Generic compatible accessory | Ship loose; all links open by default
Corner mounting screws | 4 optional | M3 socket head; length suits installation | User mounting surface / tapped hole or nut | Not included in six insert-fastened assembly screws
