mvalancy/pcb-agx-thor-can-breakout/exports/4port/jlc-bom.csv

Comment | Designator | Footprint | LCSC Part #
CDSOT23-SM712 | D1 | SOT-23 | C404012
CDSOT23-SM712 | D2 | SOT-23 | C404012
CDSOT23-SM712 | D3 | SOT-23 | C404012
CDSOT23-SM712 | D4 | SOT-23 | C404012
