mvalancy/pcb-agx-thor-can-breakout/exports/asm_4port_header.step

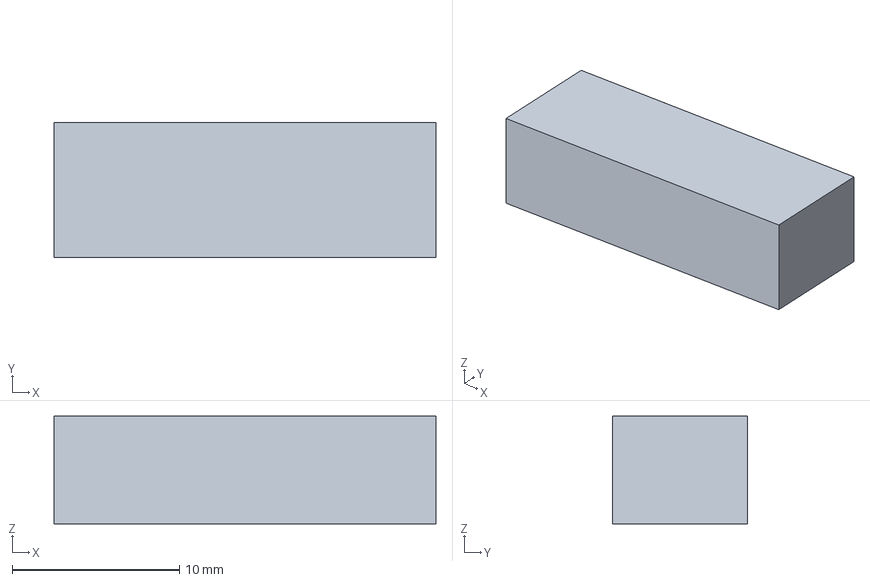
[picture p19: CAD file, 2026-11-03]
exports/asm_4port_header.step
22.9 x 8.07 x 6.46 mm
