mvalancy/pcb-agx-thor-can-breakout/exports/asm_4port_can_cables.step

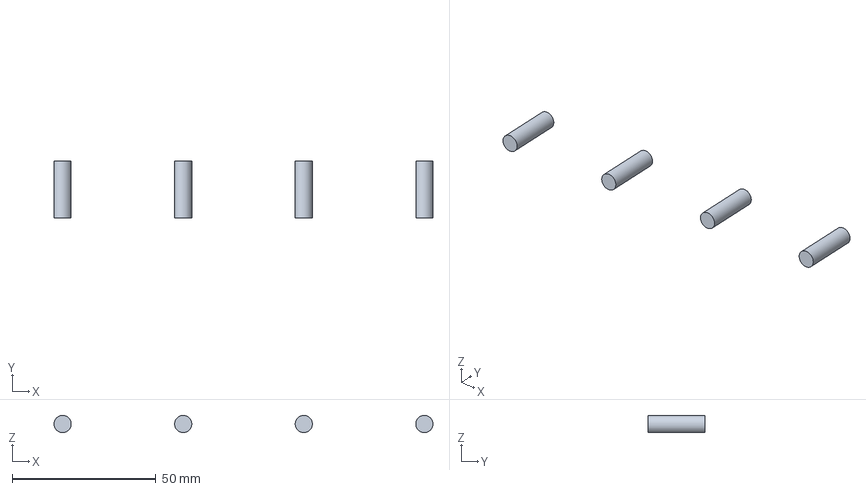
[picture p20: CAD file, 2026-11-03]
exports/asm_4port_can_cables.step
132.0 x 20.0 x 5.99 mm
asm_4port_can_cables.1
asm_4port_can_cables.2
asm_4port_can_cables.3
asm_4port_can_cables.4
