mvalancy/pcb-agx-thor-can-breakout/exports/asm_2port_clamp.step

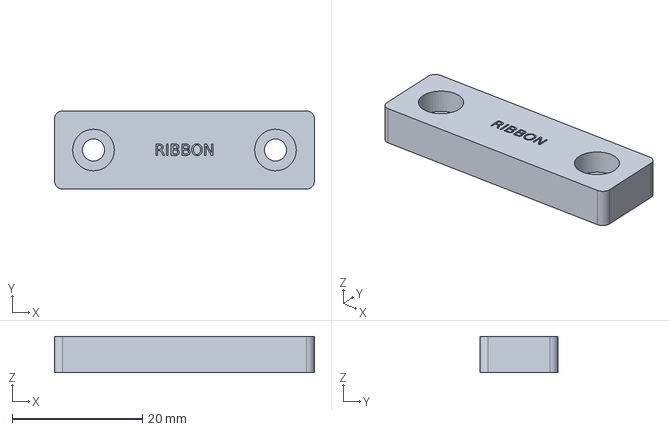
[picture p21: CAD file, 2026-11-03]
exports/asm_2port_clamp.step
40.0 x 12.0 x 5.60 mm
