mvalancy/pcb-agx-thor-can-breakout/exports/asm_2port_ribbon.step

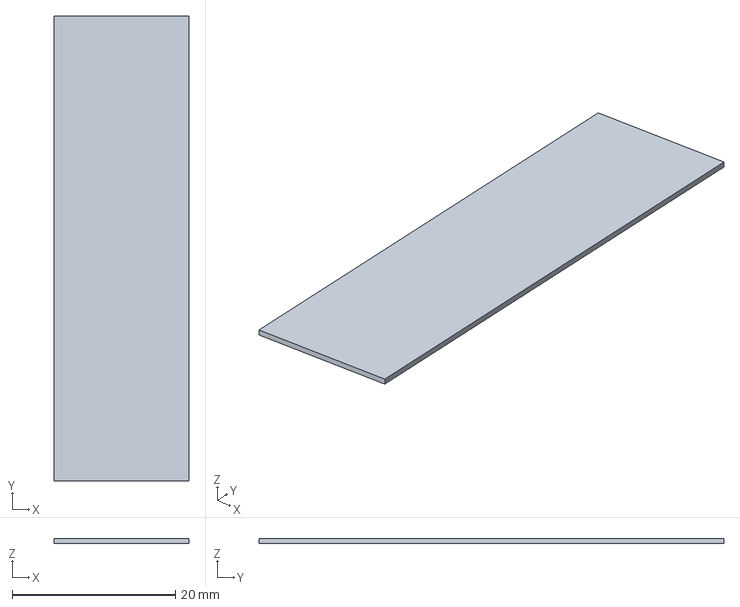
[picture p22: CAD file, 2026-11-03]
exports/asm_2port_ribbon.step
16.5 x 57.0 x 0.6 mm
