mvalancy/pcb-agx-thor-can-breakout/exports/asm_2port_can_cables.step

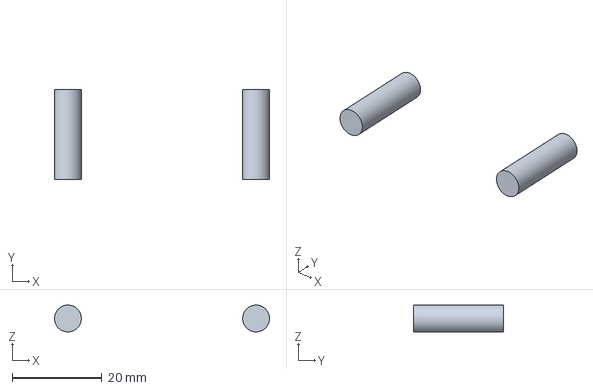
[picture p23: CAD file, 2026-11-03]
exports/asm_2port_can_cables.step
48.0 x 20.0 x 5.99 mm
asm_2port_can_cables.1
asm_2port_can_cables.2
