mvalancy/pcb-agx-thor-can-breakout/exports/asm_4port_legend_paint.step

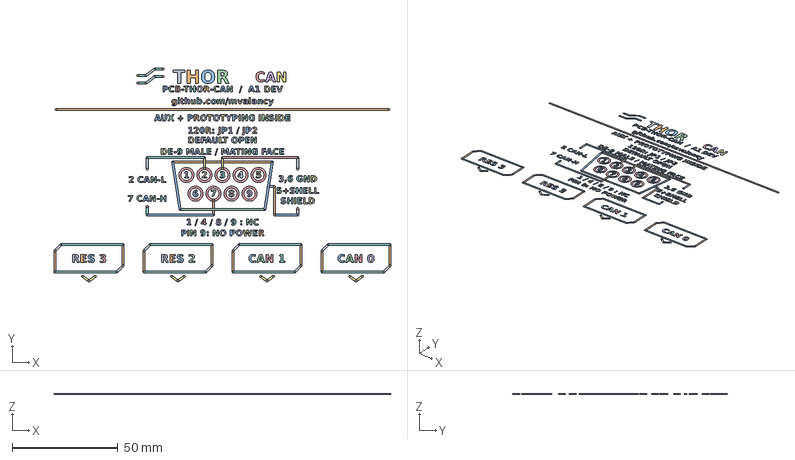
[picture p24: CAD file, 2026-11-03]
exports/asm_4port_legend_paint.step
159.0 x 101.0 x 0.03 mm
asm_4port_legend_paint.1
asm_4port_legend_paint.2
asm_4port_legend_paint.3
asm_4port_legend_paint.4
asm_4port_legend_paint.5
asm_4port_legend_paint.6
asm_4port_legend_paint.7
asm_4port_legend_paint.8
asm_4port_legend_paint.9
asm_4port_legend_paint.10
asm_4port_legend_paint.11
asm_4port_legend_paint.12
asm_4port_legend_paint.13
asm_4port_legend_paint.14
asm_4port_legend_paint.15
asm_4port_legend_paint.16
asm_4port_legend_paint.17
asm_4port_legend_paint.18
asm_4port_legend_paint.19
asm_4port_legend_paint.20
asm_4port_legend_paint.21
asm_4port_legend_paint.22
asm_4port_legend_paint.23
asm_4port_legend_paint.24
asm_4port_legend_paint.25
asm_4port_legend_paint.26
asm_4port_legend_paint.27
asm_4port_legend_paint.28
asm_4port_legend_paint.29
asm_4port_legend_paint.30
asm_4port_legend_paint.31
asm_4port_legend_paint.32
asm_4port_legend_paint.33
asm_4port_legend_paint.34
asm_4port_legend_paint.35
asm_4port_legend_paint.36
asm_4port_legend_paint.37
asm_4port_legend_paint.38
asm_4port_legend_paint.39
asm_4port_legend_paint.40
asm_4port_legend_paint.41
asm_4port_legend_paint.42
asm_4port_legend_paint.43
asm_4port_legend_paint.44
asm_4port_legend_paint.45
asm_4port_legend_paint.46
asm_4port_legend_paint.47
asm_4port_legend_paint.48
asm_4port_legend_paint.49
asm_4port_legend_paint.50
asm_4port_legend_paint.51
asm_4port_legend_paint.52
asm_4port_legend_paint.53
asm_4port_legend_paint.54
asm_4port_legend_paint.55
asm_4port_legend_paint.56
asm_4port_legend_paint.57
asm_4port_legend_paint.58
asm_4port_legend_paint.59
asm_4port_legend_paint.60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
