mvalancy/pcb-agx-thor-can-breakout/exports/asm_4port_hoods.step

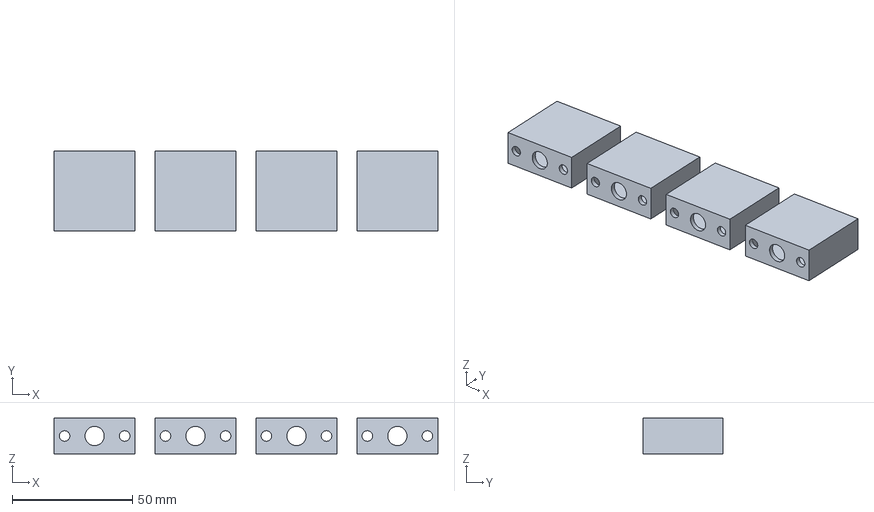
[picture p25: CAD file, 2026-11-03]
exports/asm_4port_hoods.step
159.8 x 33.3 x 14.8 mm
asm_4port_hoods.1
asm_4port_hoods.2
asm_4port_hoods.3
asm_4port_hoods.4
