mvalancy/pcb-agx-thor-can-breakout/exports/asm_2port_hoods.step

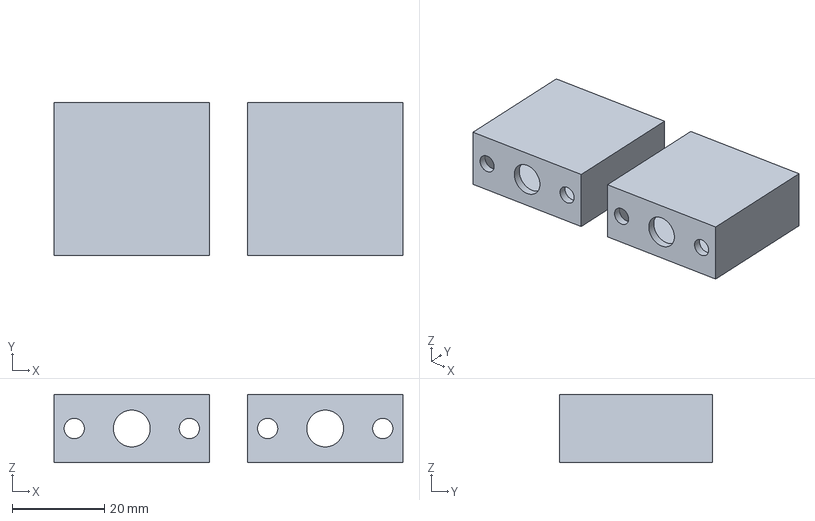
[picture p26: CAD file, 2026-11-03]
exports/asm_2port_hoods.step
75.8 x 33.3 x 14.8 mm
asm_2port_hoods.1
asm_2port_hoods.2
