mvalancy/pcb-agx-thor-can-breakout/exports/asm_4port_pcb.step

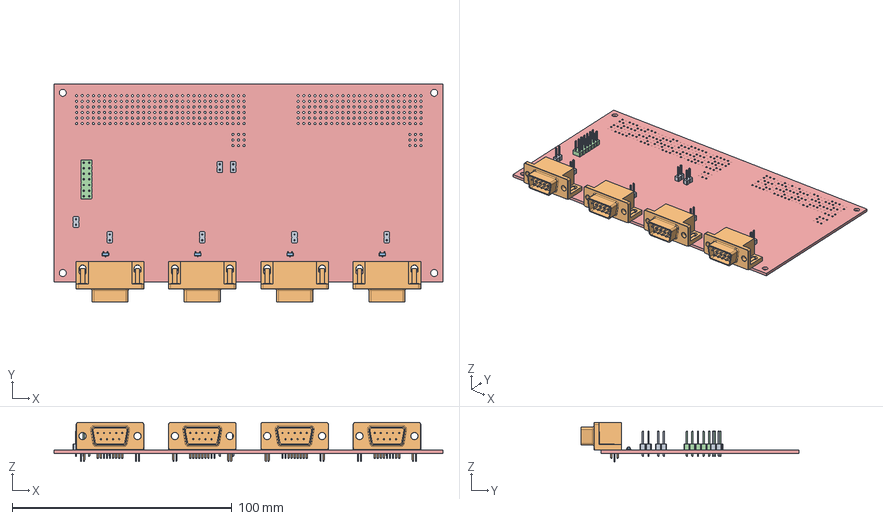
[picture p28: CAD file, 2026-11-03]
exports/asm_4port_pcb.step
177.0 x 99.1 x 17.9 mm
asm_4port_pcb.1
asm_4port_pcb.2
asm_4port_pcb.3
asm_4port_pcb.4
asm_4port_pcb.5
asm_4port_pcb.6
asm_4port_pcb.7
asm_4port_pcb.8
asm_4port_pcb.9
asm_4port_pcb.10
asm_4port_pcb.11
asm_4port_pcb.12
asm_4port_pcb.13
asm_4port_pcb.14
asm_4port_pcb.15
asm_4port_pcb.16
asm_4port_pcb.17
