mvalancy/pcb-agx-thor-can-breakout/exports/asm_2port_pcb.step

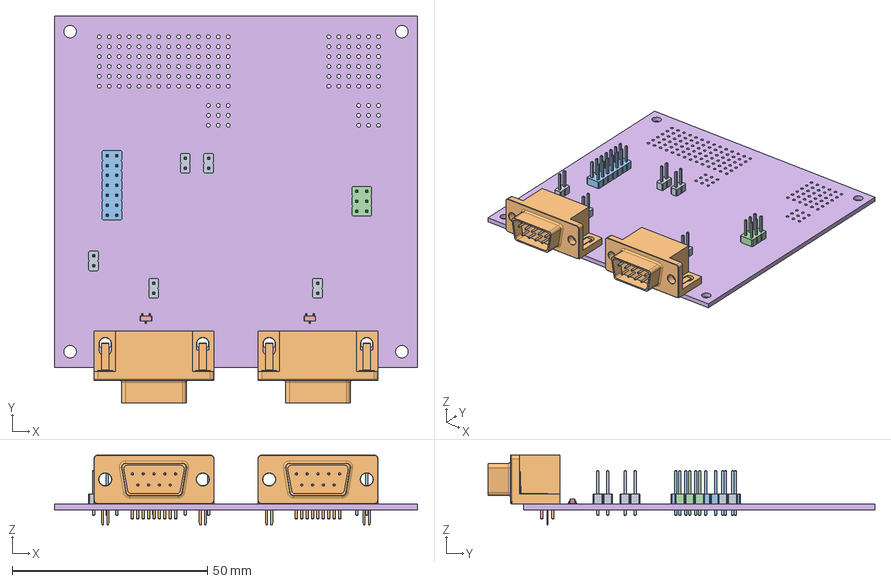
[picture p29: CAD file, 2026-11-03]
exports/asm_2port_pcb.step
93.0 x 99.1 x 17.9 mm
asm_2port_pcb.1
asm_2port_pcb.2
asm_2port_pcb.3
asm_2port_pcb.4
asm_2port_pcb.5
asm_2port_pcb.6
asm_2port_pcb.7
asm_2port_pcb.8
asm_2port_pcb.9
asm_2port_pcb.10
asm_2port_pcb.11
asm_2port_pcb.12
