mvalancy/pcb-agx-thor-can-breakout/exports/asm_4port_inserts.step

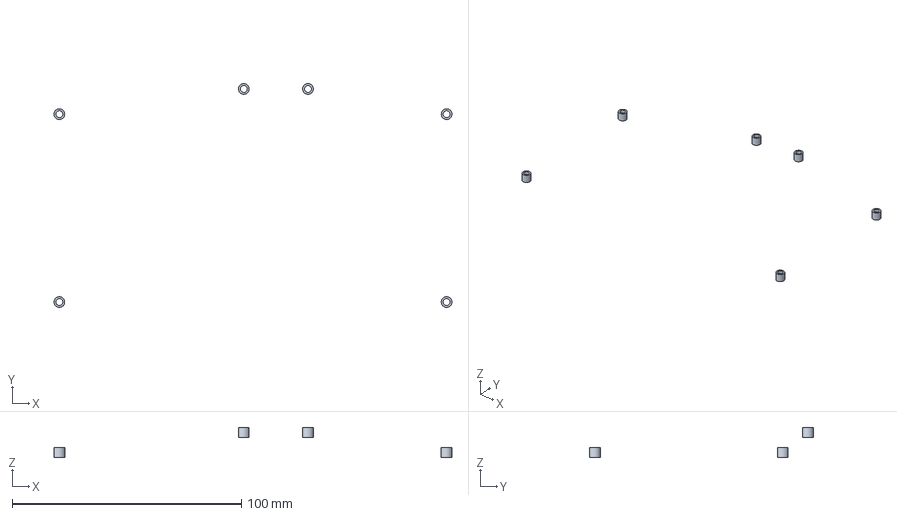
[picture p30: CAD file, 2026-11-03]
exports/asm_4port_inserts.step
173.7 x 97.7 x 13.1 mm
asm_4port_inserts.1
asm_4port_inserts.2
asm_4port_inserts.3
asm_4port_inserts.4
asm_4port_inserts.5
asm_4port_inserts.6
