mvalancy/pcb-agx-thor-can-breakout/exports/asm_2port_female.step

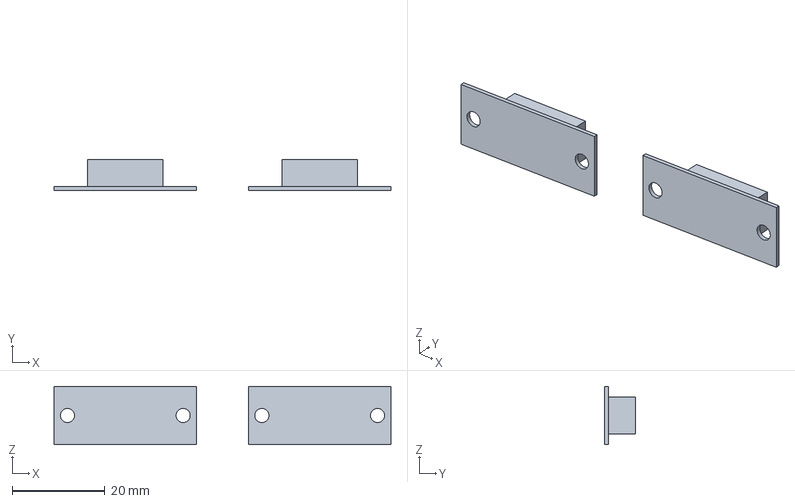
[picture p31: CAD file, 2026-11-03]
exports/asm_2port_female.step
72.8 x 6.60 x 12.5 mm
asm_2port_female.1
asm_2port_female.2
