mvalancy/pcb-agx-thor-can-breakout/exports/asm_2port_legend_paint.step

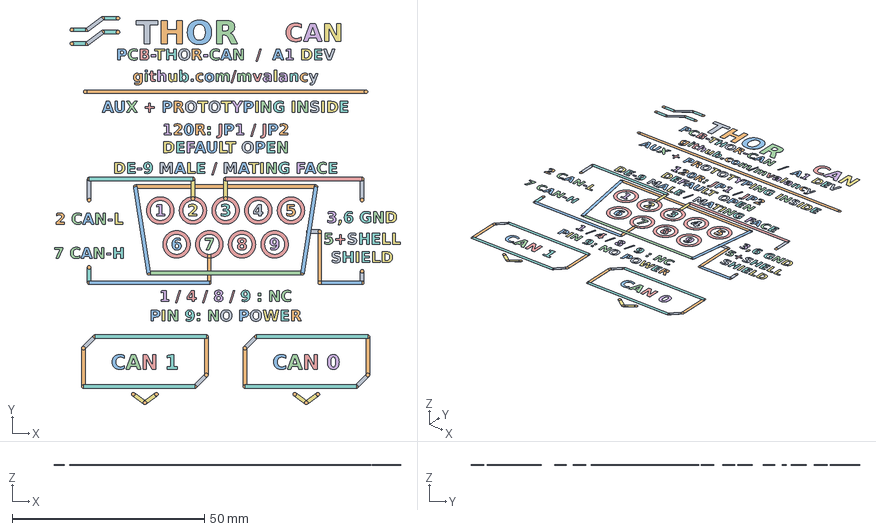
[picture p32: CAD file, 2026-11-03]
exports/asm_2port_legend_paint.step
90.0 x 101.0 x 0.03 mm
asm_2port_legend_paint.1
asm_2port_legend_paint.2
asm_2port_legend_paint.3
asm_2port_legend_paint.4
asm_2port_legend_paint.5
asm_2port_legend_paint.6
asm_2port_legend_paint.7
asm_2port_legend_paint.8
asm_2port_legend_paint.9
asm_2port_legend_paint.10
asm_2port_legend_paint.11
asm_2port_legend_paint.12
asm_2port_legend_paint.13
asm_2port_legend_paint.14
asm_2port_legend_paint.15
asm_2port_legend_paint.16
asm_2port_legend_paint.17
asm_2port_legend_paint.18
asm_2port_legend_paint.19
asm_2port_legend_paint.20
asm_2port_legend_paint.21
asm_2port_legend_paint.22
asm_2port_legend_paint.23
asm_2port_legend_paint.24
asm_2port_legend_paint.25
asm_2port_legend_paint.26
asm_2port_legend_paint.27
asm_2port_legend_paint.28
asm_2port_legend_paint.29
asm_2port_legend_paint.30
asm_2port_legend_paint.31
asm_2port_legend_paint.32
asm_2port_legend_paint.33
asm_2port_legend_paint.34
asm_2port_legend_paint.35
asm_2port_legend_paint.36
asm_2port_legend_paint.37
asm_2port_legend_paint.38
asm_2port_legend_paint.39
asm_2port_legend_paint.40
asm_2port_legend_paint.41
asm_2port_legend_paint.42
asm_2port_legend_paint.43
asm_2port_legend_paint.44
asm_2port_legend_paint.45
asm_2port_legend_paint.46
asm_2port_legend_paint.47
asm_2port_legend_paint.48
asm_2port_legend_paint.49
asm_2port_legend_paint.50
asm_2port_legend_paint.51
asm_2port_legend_paint.52
asm_2port_legend_paint.53
asm_2port_legend_paint.54
asm_2port_legend_paint.55
asm_2port_legend_paint.56
asm_2port_legend_paint.57
asm_2port_legend_paint.58
asm_2port_legend_paint.59
asm_2port_legend_paint.60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
