mvalancy/pcb-agx-thor-can-breakout/exports/asm_4port_female.step

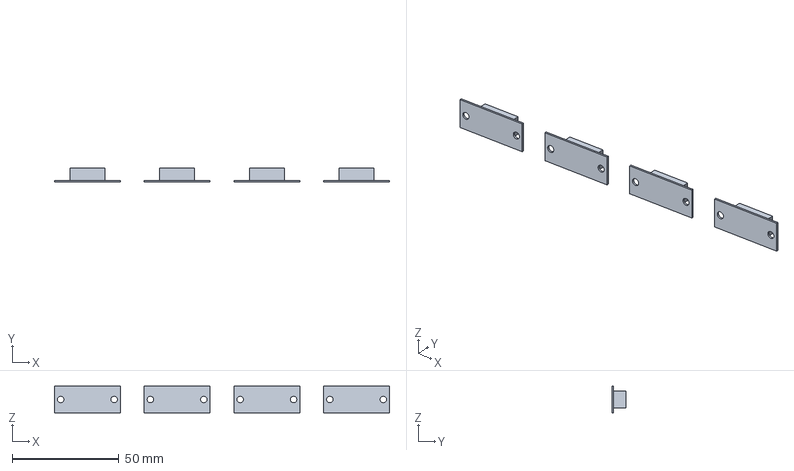
[picture p33: CAD file, 2026-11-03]
exports/asm_4port_female.step
156.8 x 6.60 x 12.5 mm
asm_4port_female.1
asm_4port_female.2
asm_4port_female.3
asm_4port_female.4
