mvalancy/pcb-agx-thor-can-breakout/exports/4port_base.step

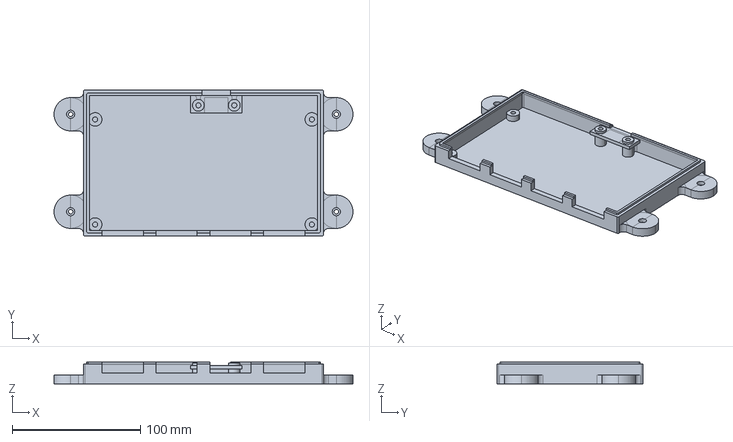
[picture p34: CAD file, 2026-11-03]
exports/4port_base.step
233.2 x 114.2 x 16.9 mm
