mvalancy/pcb-agx-thor-can-breakout/exports/view/2port_base.stl

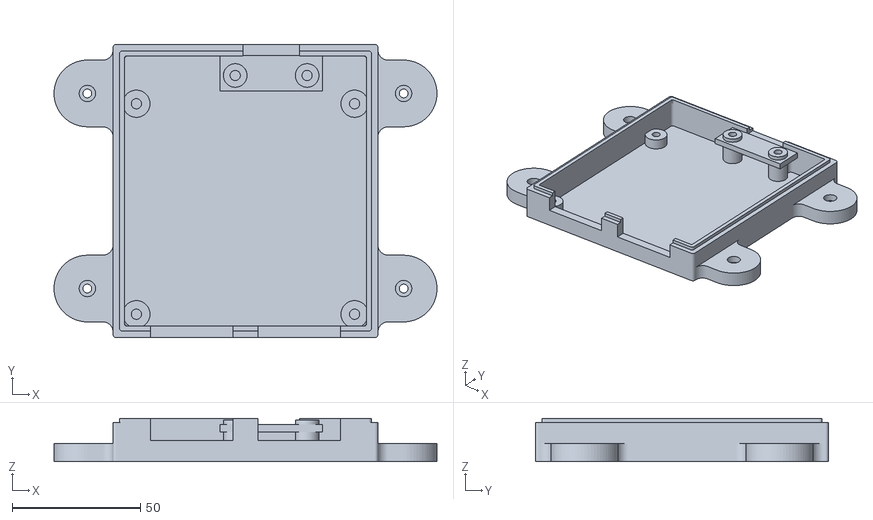
[picture p35: CAD file, 2026-11-03]
exports/view/2port_base.stl
149.2 x 114.2 x 16.9
