mvalancy/pcb-agx-thor-can-breakout/exports/port_coupon.step

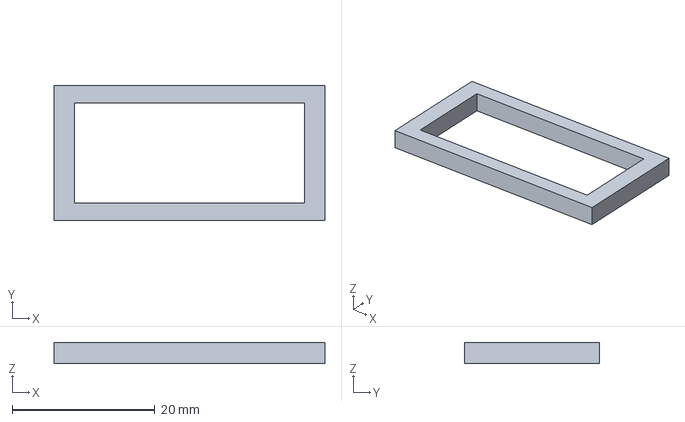
[picture p36: CAD file, 2026-11-03]
exports/port_coupon.step
38.0 x 19.0 x 3.00 mm
