mvalancy/pcb-agx-thor-can-breakout/exports/4port_lid.step

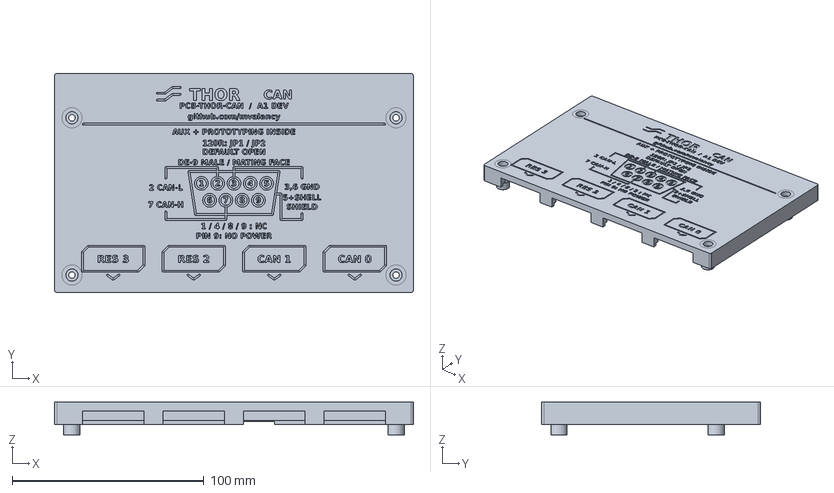
[picture p37: CAD file, 2026-11-03]
exports/4port_lid.step
187.2 x 114.2 x 17.0 mm
