mvalancy/pcb-agx-thor-can-breakout/exports/view/fastener_coupon.stl

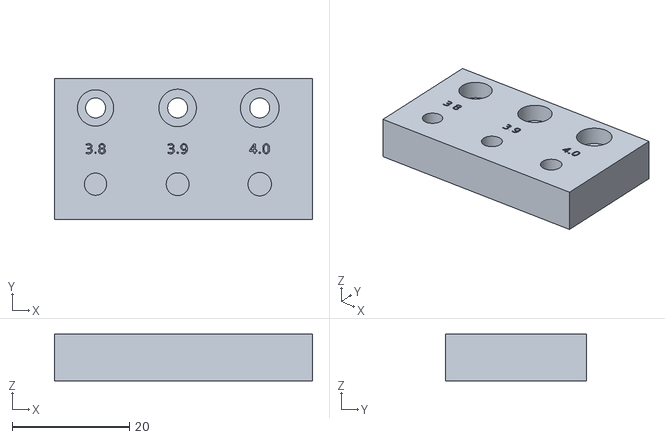
[picture p38: CAD file, 2026-11-03]
exports/view/fastener_coupon.stl
44.0 x 24.0 x 8.00
