mvalancy/pcb-agx-thor-can-breakout/exports/view/2port_lid.stl

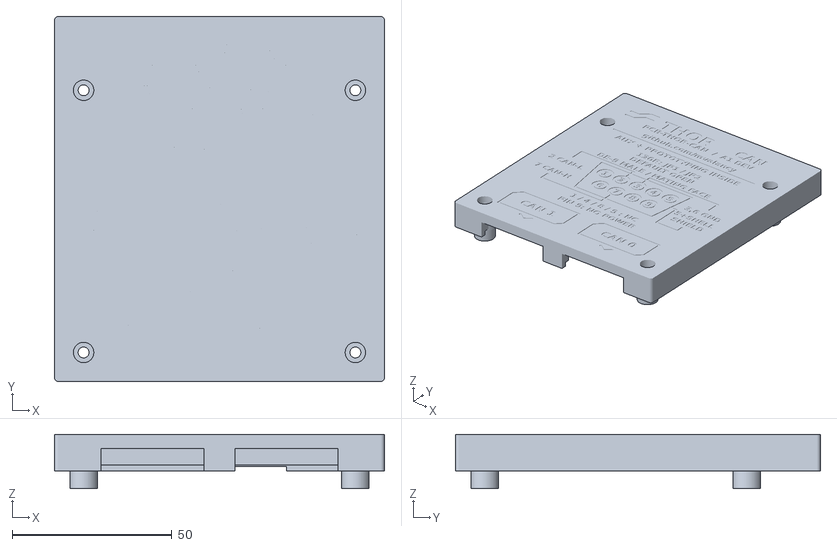
[picture p39: CAD file, 2026-11-03]
exports/view/2port_lid.stl
103.2 x 114.2 x 17.0
