mvalancy/pcb-agx-thor-can-breakout/exports/pcb-agx-thor-can-breakout-plates.3mf

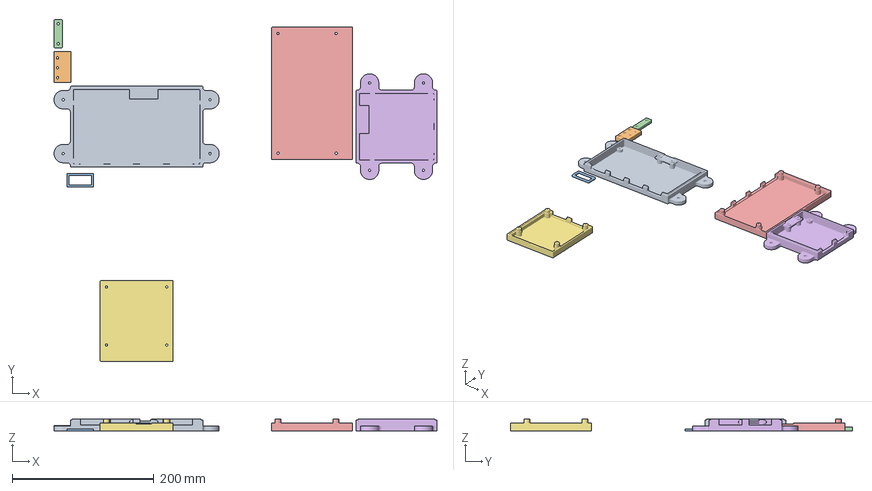
[picture p40: CAD file, 2026-11-03]
exports/pcb-agx-thor-can-breakout-plates.3mf
540.5 x 482.4 x 17.0 mm
4port_base
fastener_coupon
port_coupon
ribbon_clamp
4port_lid
2port_base
2port_lid
