mvalancy/pcb-agx-thor-can-breakout/(list of files, cad)

Other CAD files:
exports/asm_2port_header.step
exports/asm_4port_ribbon.step
exports/asm_4port_clamp.step
exports/2port/pcb.step
exports/4port/pcb.step
exports/view/4port_legend_paint.stl
exports/view/4port_can_cables.stl
exports/view/2port_female.stl
exports/view/4port_inserts.stl
exports/view/2port_clamp.stl
exports/view/2port_hoods.stl
exports/view/4port_female.stl
exports/view/4port_base.stl
exports/view/4port_pcb.stl
exports/view/4port_hoods.stl
exports/view/2port_can_cables.stl
exports/view/port_coupon.stl
exports/view/4port_clamp.stl
exports/fastener_coupon.step
exports/view/2port_ribbon.stl
exports/view/2port_legend_paint.stl
exports/2port_base.step
exports/view/4port_header.stl
exports/view/2port_header.stl
exports/2port_lid.step
exports/view/ribbon_clamp.stl
exports/view/2port_pcb.stl
exports/ribbon_clamp.step
exports/view/2port_inserts.stl
exports/view/4port_lid.stl
exports/view/4port_ribbon.stl
exports/2port_base.3mf
exports/2port_base.stl
exports/2port_lid.3mf
exports/2port_lid.stl
exports/4port_base.3mf
exports/4port_base.stl
exports/4port_lid.3mf
exports/4port_lid.stl
exports/asm_2port_screws.step
exports/asm_2port_thumbscrews.step
exports/asm_4port_screws.step
exports/asm_4port_thumbscrews.step
exports/fastener_coupon.3mf
exports/fastener_coupon.stl
exports/port_coupon.3mf
exports/port_coupon.stl
exports/ribbon_clamp.3mf
exports/ribbon_clamp.stl
exports/view/2port_screws.stl
exports/view/2port_thumbscrews.stl
exports/view/4port_screws.stl
exports/view/4port_thumbscrews.stl
