mvalancy/pcb-agx-thor-can-breakout/exports/2port/fabrication-review/README.md

<!-- generated by tools/write_readmes.py -->
# 2-port fabrication layers

[Project overview](../../../README.md) · [Documentation](../../../docs/README.md) · [Local design review](http://localhost:8765/site/)

Two-layer Gerber and Excellon data generated from the native KiCad board.

Use the [parent fabrication ZIP](../thor-2port-A1-fabrication-REVIEW.zip) to keep the layer set together. These files are for **A1 engineering review**, not an approved 50-unit order.

| Layer family | Purpose |
|---|---|
| F_Cu / B_Cu | Top routing and bottom copper/reference plane |
| F_Mask / B_Mask | Solder-mask openings |
| F_Paste / F_Silkscreen | Top stencil and component markings |
| Edge_Cuts | Finished board outline |
| PTH / NPTH | Separate plated and non-plated drill files and maps |
| Gerber job | Exported layer/job metadata |

Nominal stack: 1.6 mm FR4, two layers, 1 oz copper. Supplier stackup, mask, panelization and assembly checks remain required. [Manufacturing guide](../../../docs/manufacturing.md).

<details>
<summary>Complete folder index</summary>

| File or folder | Purpose |
|---|---|
| [README.txt](README.txt) | Project support file |
| [thor-2port-B_Cu.gbl](thor-2port-B_Cu.gbl) | Project support file |
| [thor-2port-B_Mask.gbs](thor-2port-B_Mask.gbs) | Project support file |
| [thor-2port-B_Silkscreen.gbo](thor-2port-B_Silkscreen.gbo) | Project support file |
| [thor-2port-Edge_Cuts.gm1](thor-2port-Edge_Cuts.gm1) | Project support file |
| [thor-2port-F_Cu.gtl](thor-2port-F_Cu.gtl) | Project support file |
| [thor-2port-F_Mask.gts](thor-2port-F_Mask.gts) | Project support file |
| [thor-2port-F_Paste.gtp](thor-2port-F_Paste.gtp) | Project support file |
| [thor-2port-F_Silkscreen.gto](thor-2port-F_Silkscreen.gto) | Project support file |
| [thor-2port-NPTH-drl_map.pdf](thor-2port-NPTH-drl_map.pdf) | Printable review drawing |
| [thor-2port-NPTH.drl](thor-2port-NPTH.drl) | Project support file |
| [thor-2port-PTH-drl_map.pdf](thor-2port-PTH-drl_map.pdf) | Printable review drawing |
| [thor-2port-PTH.drl](thor-2port-PTH.drl) | Project support file |
| [thor-2port-job.gbrjob](thor-2port-job.gbrjob) | Project support file |

</details>
