mvalancy/pcb-agx-thor-can-breakout/exports/2port/fabrication-review/README.txt

A1 DEVELOPMENT / DO NOT ORDER
Prototype connector mating, exact DE9 sourcing, assembly placement review and hardware qualification are incomplete.
2 layers, 1.6 mm FR4, 1 oz copper; supplier DFM and stackup approval required.
See docs/release-checklist.md and docs/manufacturing.md.
