mvalancy/pcb-agx-thor-can-breakout/.agents/issues/README.md

<!-- generated by tools/write_readmes.py -->
# Failure patterns

[Project overview](../../README.md) · [Documentation](../../docs/README.md) · [Local design review](http://localhost:8765/site/)

Diagnostics for recurring CAD, electrical-parity and packaging failures.

[Geometry and parity](geometry-and-parity.md) collects known symptoms. New incidents belong in the [inbox](../inbox/README.md) with enough evidence to distinguish a real correction from a passing but irrelevant check.

<details>
<summary>Complete folder index</summary>

| File or folder | Purpose |
|---|---|
| [geometry-and-parity.md](geometry-and-parity.md) | CAD can look correct while its interface is wrong |

</details>
