mvalancy/pcb-agx-thor-can-breakout/releases/release-notes.md

# A1 engineering pre-release

Download the PCB ZIP for the selected variant and the housings ZIP. SHA256SUMS identifies every download; each ZIP also includes member hashes.

Contains native KiCad schematics/routed boards, Gerber/drill review files, schematic PDFs, PCB/assembly views, exact-source assembly populations and check reports. Housing files include STL/STEP/3MF, two fit coupons, a replaceable ribbon clamp, filleted insert supports, four broad recessed corner mounting ears (26 mm wide, R4 roots, 7 mm thick), six shown assembly screws, and heat-set/silicone-pad instructions. Lid markings use larger bold lettering and 1 mm graphic strokes; native spacing and offline lid-only slicing reports include first-layer toolpath proofs. The 90 mm-deep PCBs add 120/324 isolated prototype pads, gated power taps, readable silkscreen and illustrated termination/I/O controls.

The design has undergone multiple electrical and mechanical iterations. Native reports, semantic connector checks, source freshness, assembly-path/collision screens and mesh/3MF checks are recorded. CI verifies committed evidence; it does not fabricate or test hardware.

Open: Wieson procurement/current mechanical drawing and cable fit, exact IGX carrier compatibility, printed fit/pull/creep tests, intended CAN bitrates and transient qualification, JLC DFM/stock/panelization/placement approval. No production order has been placed. This release is not suitable for an unreviewed 50-unit order.
