mvalancy/pcb-agx-thor-can-breakout/exports/2port/schematic.pdf

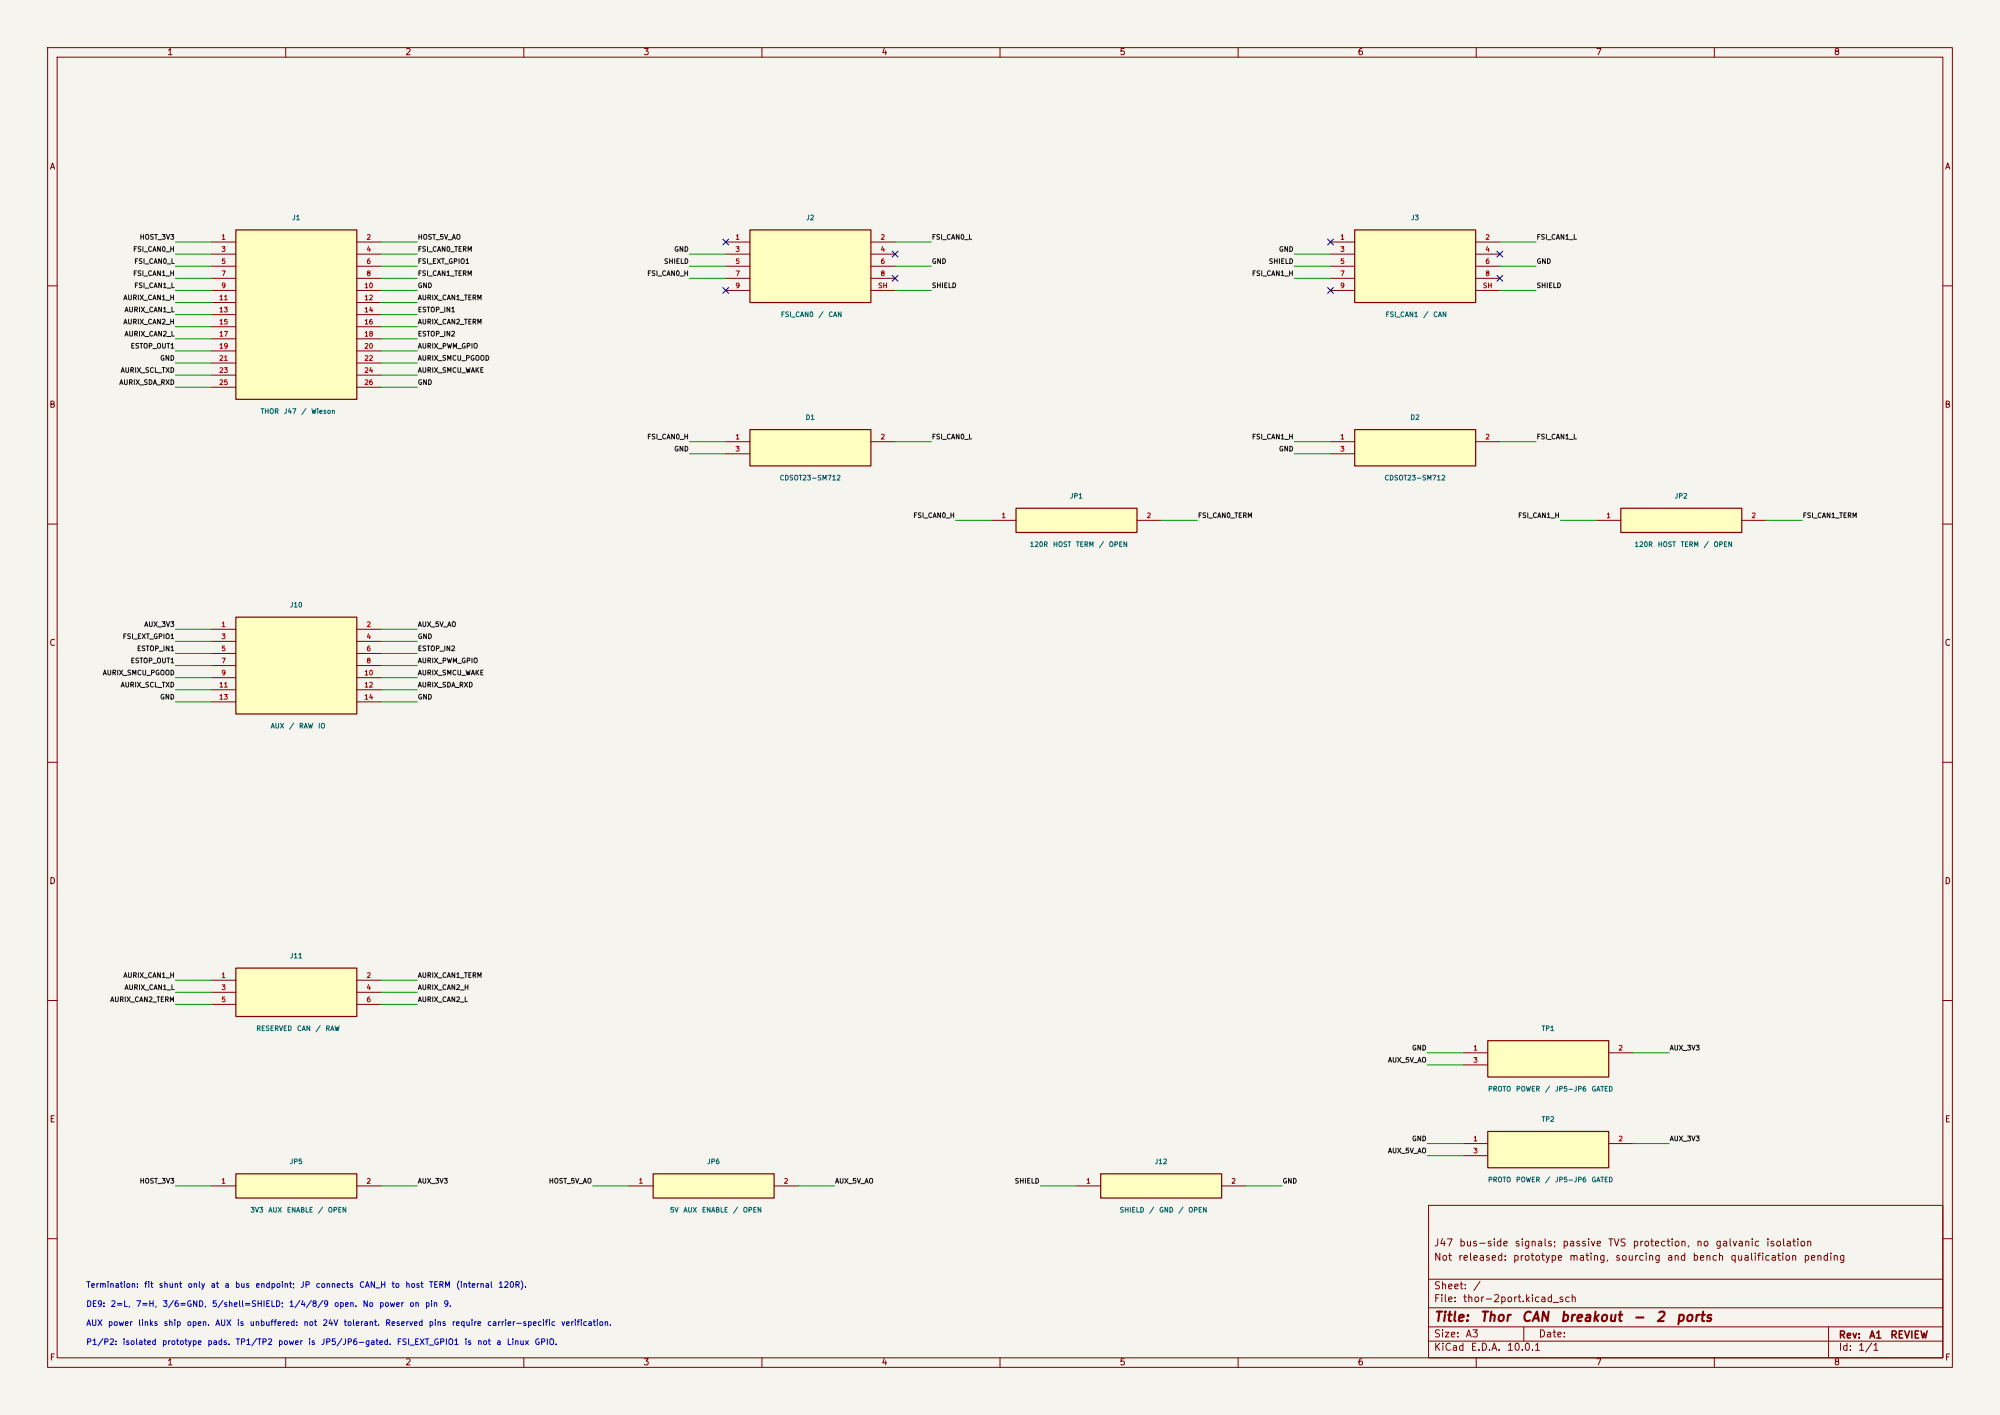
[picture p41: page 1]

J47 bus-side signals; passive TVS protection, no galvanic isolation
Not released: prototype mating, sourcing and bench qualification pending

AUX power links ship open. AUX is unbuffered: not 24V tolerant. Reserved pins require carrier-specific verification. DE9: 2=L, 7=H, 3/6=GND, 5/shell=SHIELD; 1/4/8/9 open. No power on pin 9. P1/P2: isolated prototype pads. TP1/TP2 power is JP5/JP6-gated. FSI_EXT_GPIO1 is not a Linux GPIO. Termination: fit shunt only at a bus endpoint; JP connects CAN_H to host TERM (internal 120R).

Sheet: /
File: thor-2port.kicad_sch
Title: Thor CAN breakout - 2 ports

Size: A3 | Rev: A1 REVIEW | F Date:
KiCad E.D.A. 10.0.1 | Id: 1/1
