mvalancy/pcb-agx-thor-can-breakout/(list of files, drawings)

Other design files:
exports/2port/pcb-evidence.json
exports/4port/pcb-evidence.json
exports/pcb-agx-thor-can-breakout-plates.json
