mvalancy/pcb-agx-thor-can-breakout/hardware/2port/thor-2port.kicad_pcb

## KiCad design hardware/2port/thor-2port.kicad_pcb (2026-11-03)

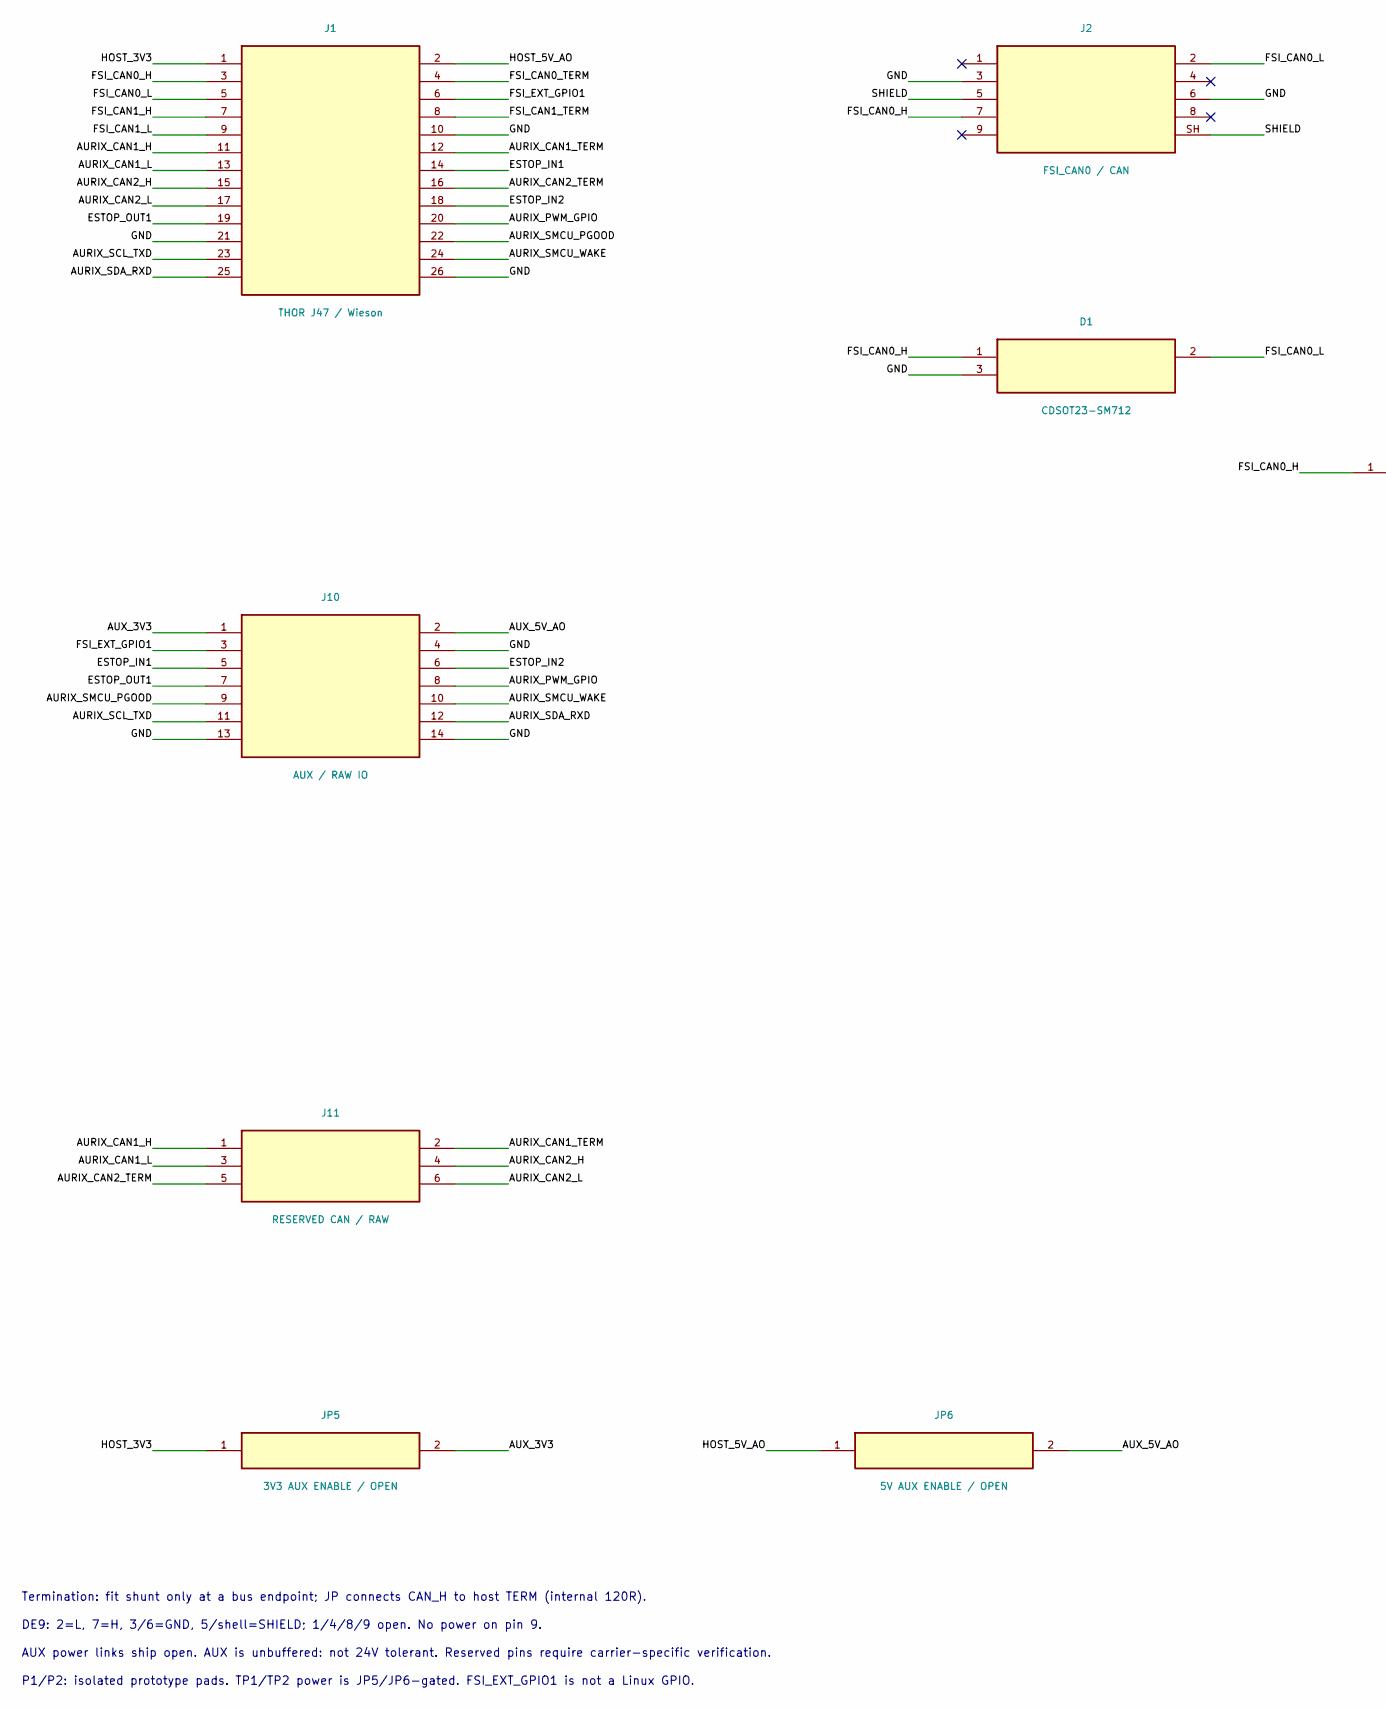
[picture p42: schematic thor-2port.kicad_sch, Thor CAN breakout - 2 ports, part in row 1, column 1]

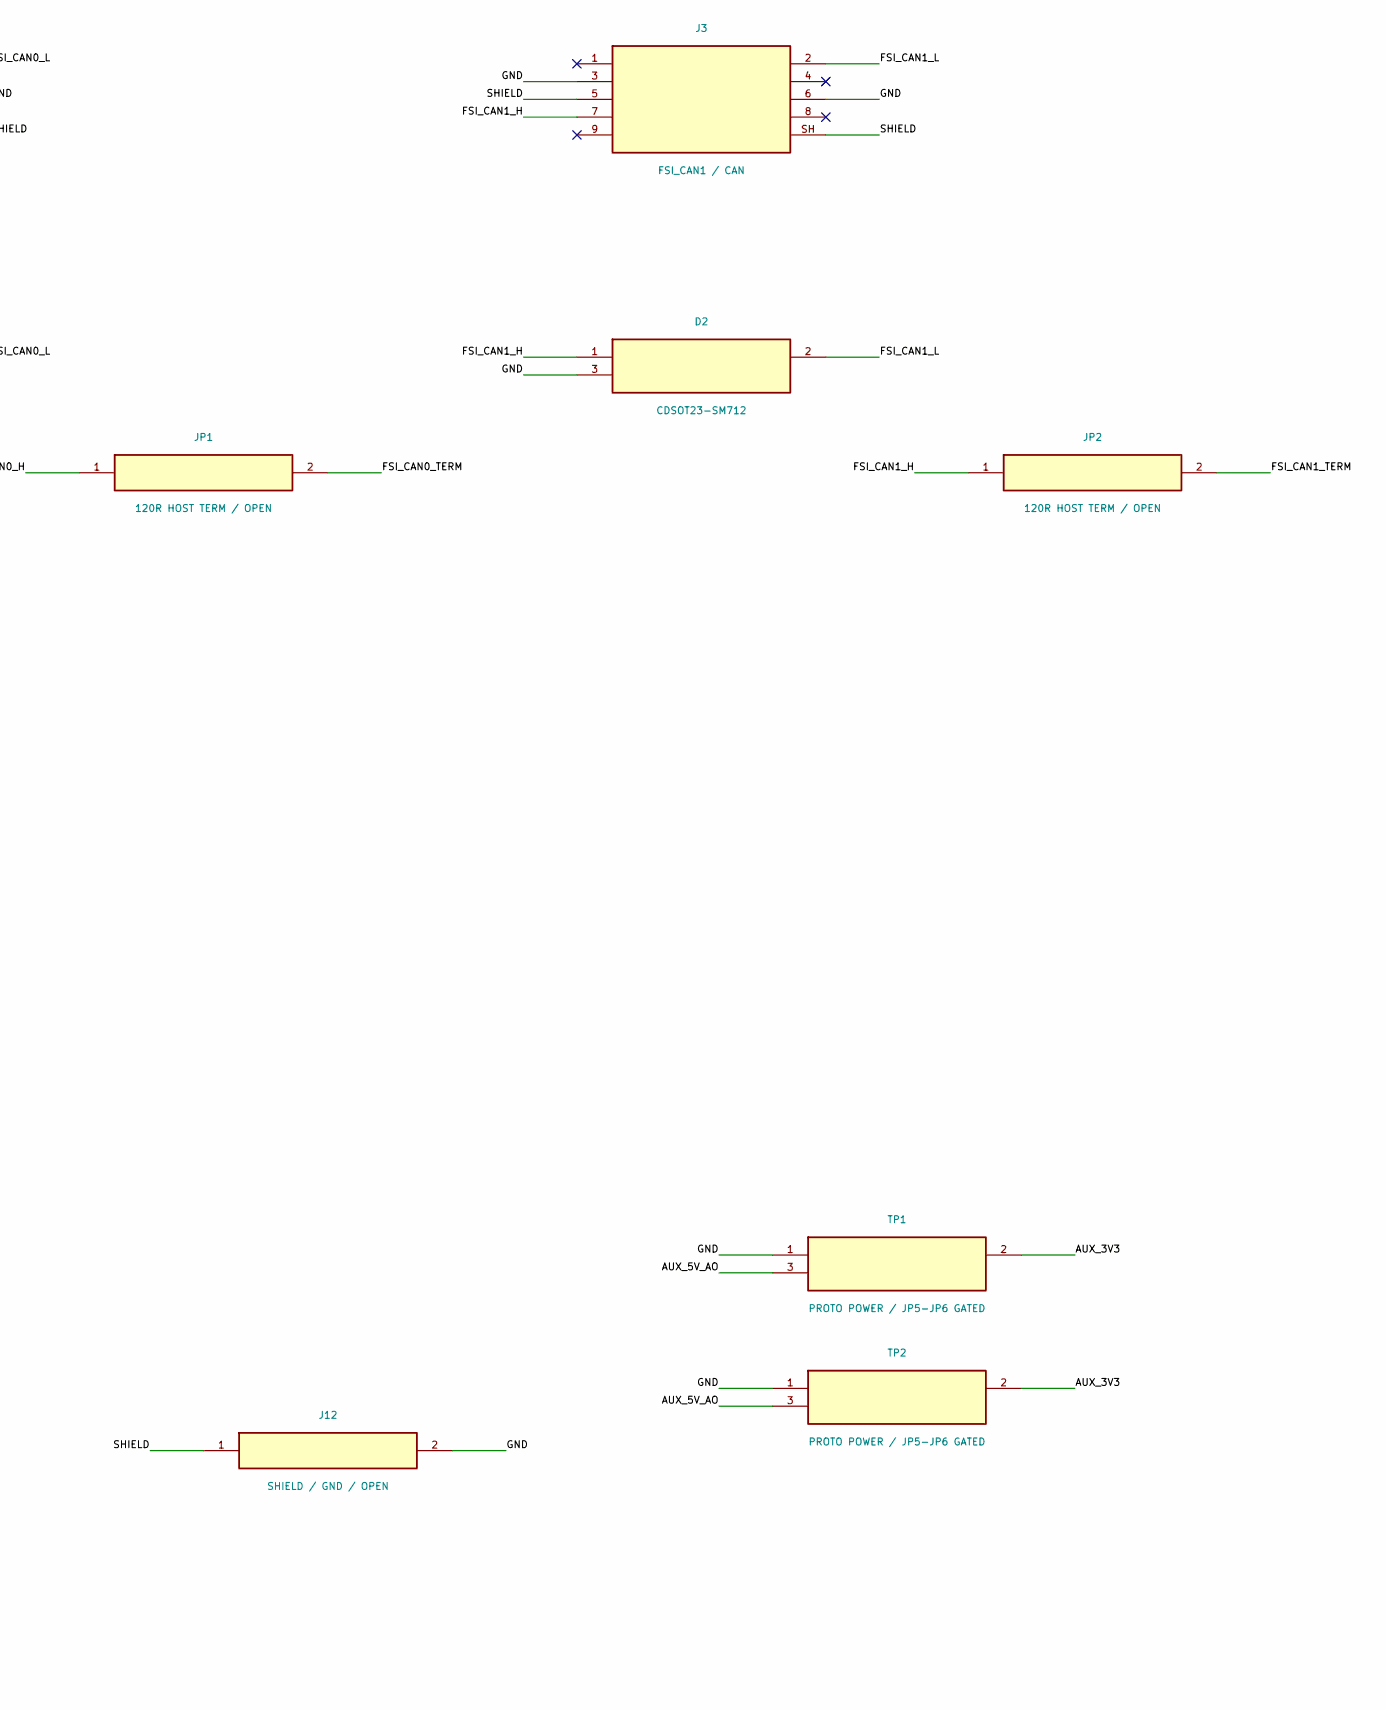
[picture p43: schematic thor-2port.kicad_sch, Thor CAN breakout - 2 ports, part in row 1, column 2]

Parts:
D1, D2: CDSOT23-SM712; SOT-23; MPN CDSOT23-SM712; LCSC C404012
J1: THOR J47 / Wieson; Wieson_AC2800-0011-022-H0; MPN AC2800-0011-022-H0
J2: FSI_CAN0 / CAN; Assmann_A-DS_09_A-KG-T2S; MPN A-DS 09 A/KG-T2S; LCSC C3127392
J3: FSI_CAN1 / CAN; Assmann_A-DS_09_A-KG-T2S; MPN A-DS 09 A/KG-T2S; LCSC C3127392
J10: AUX / RAW IO; PinHeader_2x07_P2.54mm_Vertical; MPN BOOMELE 2.54-2x7P male C71397; LCSC C71397
J11: RESERVED CAN / RAW; PinHeader_2x03_P2.54mm_Vertical; MPN BOOMELE 2.54-2x3P male C65114; LCSC C65114
J12: SHIELD / GND / OPEN; XFCN_PZ254V-11-02P; MPN PZ254V-11-02P; LCSC C492401
JP1, JP2: 120R HOST TERM / OPEN; XFCN_PZ254V-11-02P; MPN PZ254V-11-02P; LCSC C492401
JP5: 3V3 AUX ENABLE / OPEN; XFCN_PZ254V-11-02P; MPN PZ254V-11-02P; LCSC C492401
JP6: 5V AUX ENABLE / OPEN; XFCN_PZ254V-11-02P; MPN PZ254V-11-02P; LCSC C492401
TP1, TP2: PROTO POWER / JP5-JP6 GATED; Prototype_Power_3x3_P2.54

Connections:
/AURIX_CAN1_H: J1.11 (AURIX_CAN1_H), J11.1 (AURIX_CAN1_H)
/AURIX_CAN1_L: J1.13 (AURIX_CAN1_L), J11.3 (AURIX_CAN1_L)
/AURIX_CAN1_TERM: J1.12 (AURIX_CAN1_TERM), J11.2 (AURIX_CAN1_TERM)
/AURIX_CAN2_H: J1.15 (AURIX_CAN2_H), J11.4 (AURIX_CAN2_H)
/AURIX_CAN2_L: J1.17 (AURIX_CAN2_L), J11.6 (AURIX_CAN2_L)
/AURIX_CAN2_TERM: J1.16 (AURIX_CAN2_TERM), J11.5 (AURIX_CAN2_TERM)
/AURIX_PWM_GPIO: J1.20 (AURIX_PWM_GPIO), J10.8 (AURIX_PWM_GPIO)
/AURIX_SCL_TXD: J1.23 (AURIX_SCL_TXD), J10.11 (AURIX_SCL_TXD)
/AURIX_SDA_RXD: J1.25 (AURIX_SDA_RXD), J10.12 (AURIX_SDA_RXD)
/AURIX_SMCU_PGOOD: J1.22 (AURIX_SMCU_PGOOD), J10.9 (AURIX_SMCU_PGOOD)
/AURIX_SMCU_WAKE: J1.24 (AURIX_SMCU_WAKE), J10.10 (AURIX_SMCU_WAKE)
/AUX_3V3: J10.1 (AUX_3V3), JP5.2 (AUX_3V3), TP1.2 (AUX_3V3), TP2.2 (AUX_3V3)
/AUX_5V_AO: J10.2 (AUX_5V_AO), JP6.2 (AUX_5V_AO), TP1.3 (AUX_5V_AO), TP2.3 (AUX_5V_AO)
/ESTOP_IN1: J1.14 (ESTOP_IN1), J10.5 (ESTOP_IN1)
/ESTOP_IN2: J1.18 (ESTOP_IN2), J10.6 (ESTOP_IN2)
/ESTOP_OUT1: J1.19 (ESTOP_OUT1), J10.7 (ESTOP_OUT1)
/FSI_CAN0_H: D1.1 (FSI_CAN0_H), J1.3 (FSI_CAN0_H), J2.7 (FSI_CAN0_H), JP1.1 (FSI_CAN0_H)
/FSI_CAN0_L: D1.2 (FSI_CAN0_L), J1.5 (FSI_CAN0_L), J2.2 (FSI_CAN0_L)
/FSI_CAN0_TERM: J1.4 (FSI_CAN0_TERM), JP1.2 (FSI_CAN0_TERM)
/FSI_CAN1_H: D2.1 (FSI_CAN1_H), J1.7 (FSI_CAN1_H), J3.7 (FSI_CAN1_H), JP2.1 (FSI_CAN1_H)
/FSI_CAN1_L: D2.2 (FSI_CAN1_L), J1.9 (FSI_CAN1_L), J3.2 (FSI_CAN1_L)
/FSI_CAN1_TERM: J1.8 (FSI_CAN1_TERM), JP2.2 (FSI_CAN1_TERM)
/FSI_EXT_GPIO1: J1.6 (FSI_EXT_GPIO1), J10.3 (FSI_EXT_GPIO1)
/GND: D1.3 (GND), D2.3 (GND), J1.10 (GND), J1.21 (GND), J1.26 (GND), J2.3 (GND), J2.6 (GND), J3.3 (GND), J3.6 (GND), J10.4 (GND), J10.13 (GND), J10.14 (GND), J12.2 (GND), TP1.1 (GND), TP2.1 (GND)
/HOST_3V3: J1.1 (HOST_3V3), JP5.1 (HOST_3V3)
/HOST_5V_AO: J1.2 (HOST_5V_AO), JP6.1 (HOST_5V_AO)
/SHIELD: J2.5 (SHIELD), J2.SH (SHIELD), J3.5 (SHIELD), J3.SH (SHIELD), J12.1 (SHIELD)

Notes on the sheet:
Termination: fit shunt only at a bus endpoint; JP connects CAN_H to host TERM (internal 120R).
DE9: 2=L, 7=H, 3/6=GND, 5/shell=SHIELD; 1/4/8/9 open. No power on pin 9.
AUX power links ship open. AUX is unbuffered: not 24V tolerant. Reserved pins require carrier-specific verification.
P1/P2: isolated prototype pads. TP1/TP2 power is JP5/JP6-gated. FSI_EXT_GPIO1 is not a Linux GPIO.

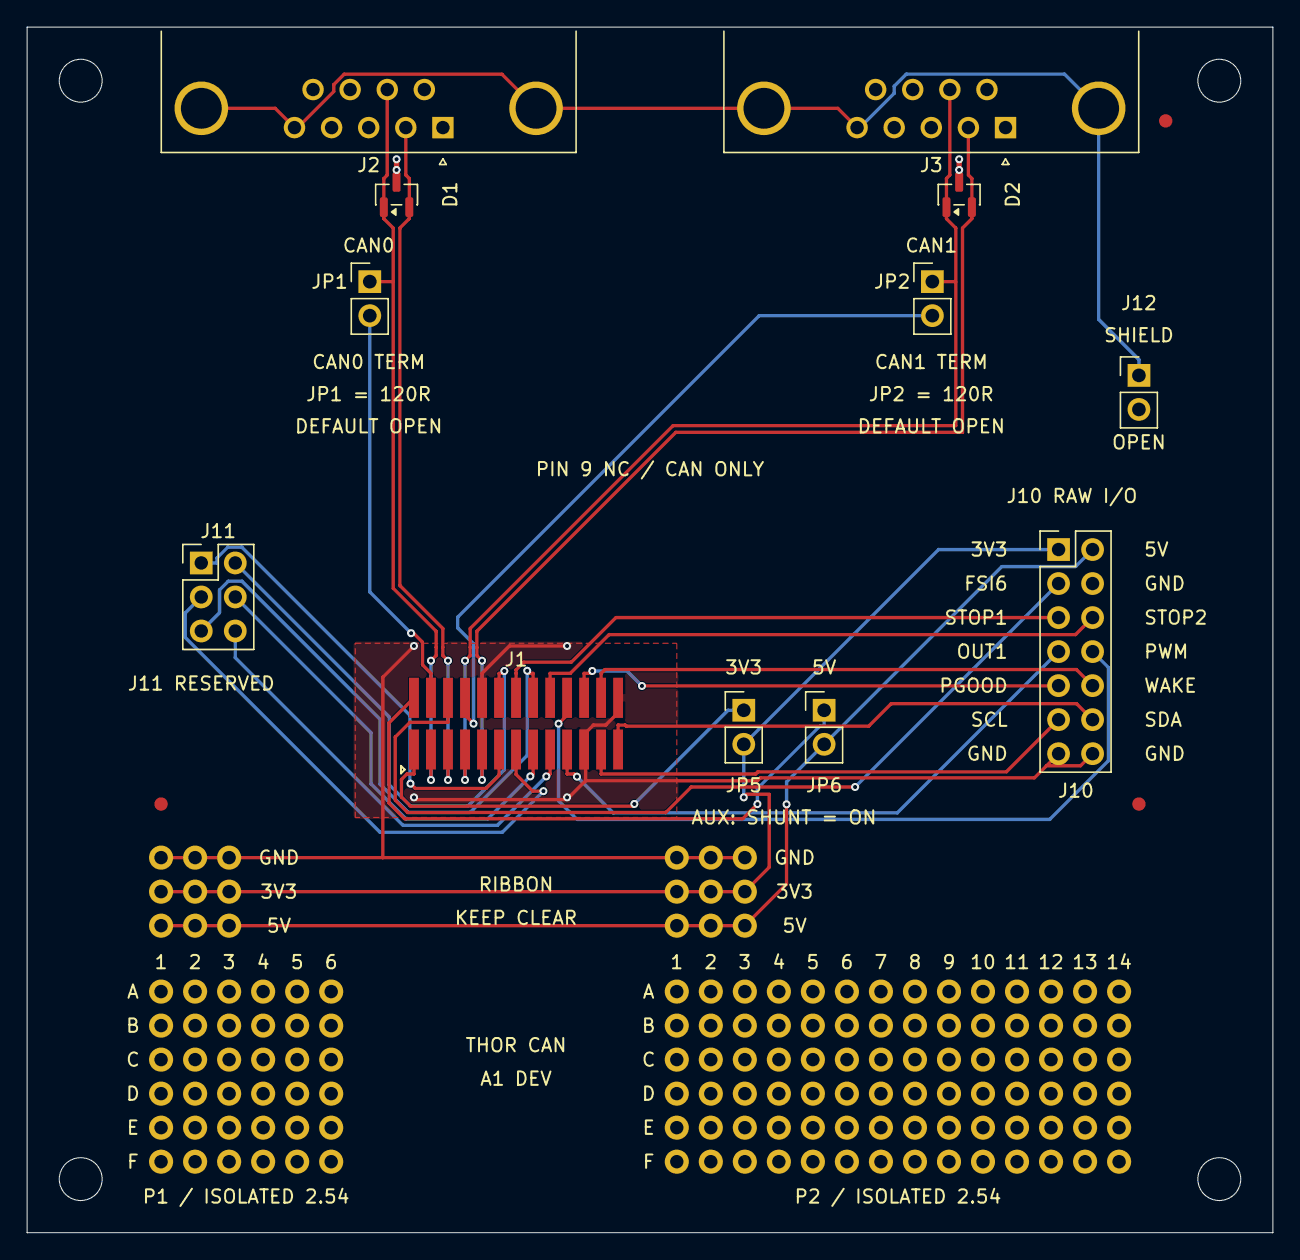
[picture p44: board thor-2port.kicad_pcb from above]

Board: 2 copper layers, 93.0 x 90.0 mm, 23 parts (0 on the bottom side), 27 nets.

Other parts of the board:
FID1, FID2, FID3: Fiducial_1mm_Mask2mm
H1, H2, H3, H4: M3; MountingHole_3.2mm_M3
P1: ISOLATED PROTOTYPING PADS; Prototype_6x6_P2.54
P2: ISOLATED PROTOTYPING PADS; Prototype_14x6_P2.54
