mvalancy/pcb-agx-thor-can-breakout/cad-agent.yaml

cad:
  name: pcb-agx-thor-can-breakout
  title: AGX Thor CAN breakout
  revision: A1-development
  serve:
    host: 127.0.0.1
    port: 8765
  site:
    title: Thor CAN breakout
    tagline: Protected CAN adapter and printed enclosure for AGX Thor · engineering
      development
    theme: light
    notice: A1 engineering review · CAD checks recorded · hardware qualification and
      JLCDFM approval pending.
    milestones: docs/milestones.yaml
    decisions: docs/decisions.yaml
    designs: exports/designs.json
    pages:
    - README.md
    - ASSEMBLY.md
    - docs/*.md
    - research/*.md
    - exports/README.md
    - releases/README.md
    live_reload:
      watch:
      - docs
      - research
      - exports
      - hardware
      - cad
      skip: []
    links:
    - title: Project repository
      href: https://github.com/mvalancy/pcb-agx-thor-can-breakout
    - title: 2-port schematic
      href: exports/2port/schematic.pdf
    - title: Enclosure gallery
      href: preview/2port-assembled.png
    review: exports/review.json
    nav:
    - id: overview
      title: Overview
      href: site/
    - id: review
      title: Design review
      href: site/#design-review
    - id: model
      title: 3D model
      href: _cadagent/kit/viewer.html
    - id: housing
      title: Enclosure
      href: site/pages/docs-enclosure-md.html
    - id: controls
      title: Controls & I/O
      href: site/pages/docs-termination-and-io-md.html
    - id: proof
      title: Pinout proof
      href: site/pages/docs-pinout-proof-md.html
    - id: checks
      title: Checks
      href: docs/cad-agent-report.html
    - id: manufacturing
      title: Manufacturing
      href: site/pages/docs-manufacturing-md.html
    - id: assembly
      title: Assembly
      href: site/pages/assembly-md.html
    - id: docs
      title: Docs
      href: site/#documents
    - id: repository
      title: Repository
      href: https://github.com/mvalancy/pcb-agx-thor-can-breakout
  holes:
    # The lids' engraved DE9 pinout: each pin number sits in a 0.4 mm deep, 1 mm wide ring (outside 7.2 mm) cut
    # into the roof (cad/markings.py). A ring around a raised numeral looks like a hole with material inside; it is
    # artwork, not a fastener or pin hole. Every other hole in every part is checked.
    exceptions:
      2port_lid:
      - {at: [29.5, 51.8, 26.6], diameter_mm: 7.2, reason: "engraved DE9 pin 1 number ring, not a hole"}
      - {at: [38.0, 51.8, 26.6], diameter_mm: 7.2, reason: "engraved DE9 pin 2 number ring, not a hole"}
      - {at: [46.5, 51.8, 26.6], diameter_mm: 7.2, reason: "engraved DE9 pin 3 number ring, not a hole"}
      - {at: [55.0, 51.8, 26.6], diameter_mm: 7.2, reason: "engraved DE9 pin 4 number ring, not a hole"}
      - {at: [63.5, 51.8, 26.6], diameter_mm: 7.2, reason: "engraved DE9 pin 5 number ring, not a hole"}
      - {at: [33.75, 43.0, 26.6], diameter_mm: 7.2, reason: "engraved DE9 pin 6 number ring, not a hole"}
      - {at: [42.25, 43.0, 26.6], diameter_mm: 7.2, reason: "engraved DE9 pin 7 number ring, not a hole"}
      - {at: [50.75, 43.0, 26.6], diameter_mm: 7.2, reason: "engraved DE9 pin 8 number ring, not a hole"}
      - {at: [59.25, 43.0, 26.6], diameter_mm: 7.2, reason: "engraved DE9 pin 9 number ring, not a hole"}
      4port_lid:
      - {at: [71.5, 51.8, 26.6], diameter_mm: 7.2, reason: "engraved DE9 pin 1 number ring, not a hole"}
      - {at: [80.0, 51.8, 26.6], diameter_mm: 7.2, reason: "engraved DE9 pin 2 number ring, not a hole"}
      - {at: [88.5, 51.8, 26.6], diameter_mm: 7.2, reason: "engraved DE9 pin 3 number ring, not a hole"}
      - {at: [97.0, 51.8, 26.6], diameter_mm: 7.2, reason: "engraved DE9 pin 4 number ring, not a hole"}
      - {at: [105.5, 51.8, 26.6], diameter_mm: 7.2, reason: "engraved DE9 pin 5 number ring, not a hole"}
      - {at: [75.75, 43.0, 26.6], diameter_mm: 7.2, reason: "engraved DE9 pin 6 number ring, not a hole"}
      - {at: [84.25, 43.0, 26.6], diameter_mm: 7.2, reason: "engraved DE9 pin 7 number ring, not a hole"}
      - {at: [92.75, 43.0, 26.6], diameter_mm: 7.2, reason: "engraved DE9 pin 8 number ring, not a hole"}
      - {at: [101.25, 43.0, 26.6], diameter_mm: 7.2, reason: "engraved DE9 pin 9 number ring, not a hole"}
  printer:
    name: Bambu P1S / prototype
    bed_mm:
    - 256
    - 256
    - 256
  slicer:
    printer: Bambu Lab P1S 0.4 nozzle
    process: 0.20mm Standard @BBL X1C
    filament: Generic PETG
    parts:
    - 2port_lid
    - 4port_lid
    - 2port_base
    - 4port_base
    - ribbon_clamp
    - fastener_coupon
    - port_coupon
    overrides:
      wall_loops: '4'
      sparse_infill_density: 30%
      curr_bed_type: Textured PEI Plate
      enable_arc_fitting: '0'
      layer_height: '0.2'
      initial_layer_print_height: '0.2'
  view:
    hidden:
    - 4port
    - ribbon_clamp
    - fastener_coupon
    - port_coupon
    colors:
      2port_base: '#263d47'
      2port_lid: '#4f788a'
      4port_base: '#253742'
      4port_lid: '#507786'
      2port_clamp: '#e8892b'
      4port_clamp: '#e8892b'
      2port_pcb: '#3d8060'
      4port_pcb: '#3d8060'
      2port_ribbon: '#bdbbb0'
      4port_ribbon: '#bdbbb0'
      2port_legend_paint: '#eeecd1'
      2port_inserts: '#d9a33d'
      2port_screws: '#b0b6bc'
      2port_female: '#acb2b8'
      2port_hoods: '#292e36'
      2port_thumbscrews: '#d18c40'
      2port_can_cables: '#181a1d'
      4port_legend_paint: '#eeecd1'
      4port_inserts: '#d9a33d'
      4port_screws: '#b0b6bc'
      4port_female: '#acb2b8'
      4port_hoods: '#292e36'
      4port_thumbscrews: '#d18c40'
      4port_can_cables: '#181a1d'
    explode:
      2port_lid:
      - 0
      - 0
      - 1
      4port_lid:
      - 0
      - 0
      - 1
    extra:
    - glob: exports/asm_*.step
      strip: asm_
    groups:
    - id: 2port
      title: Thor 2-port assembly
      prefix: 2port_
    - id: 4port
      title: Thor 4-port assembly
      prefix: 4port_
  steps:
  - name: mechanical
    run: cad/build.py
    log: mechanical-build.log
  - name: control-drawings
    run: tools/draw_controls.py
  - name: dimensional-drawings
    run: tools/draw_mechanics.py
  - name: lid-markings
    run: tools/check_lid_markings.py
  - name: render-readbacks
    run: tools/render_review.py
  - name: assembly-paths
    run: tools/check_mechanics.py
  - name: electrical
    run: tools/check_electronics.py
  - name: evidence
    run: tools/update_evidence.py
  checks:
  - id: 2port-electrical-review
    title: 2port electrical-review
    file: exports/2port/electrical-review.json
  - id: 2port-mechanical-checks
    title: 2port mechanical-checks
    file: exports/2port/mechanical-checks.json
  - id: 4port-electrical-review
    title: 4port electrical-review
    file: exports/4port/electrical-review.json
  - id: 4port-mechanical-checks
    title: 4port mechanical-checks
    file: exports/4port/mechanical-checks.json
  - id: 2port-paths
    title: 2port assembly paths
    file: exports/2port/assembly-paths.json
  - id: 4port-paths
    title: 4port assembly paths
    file: exports/4port/assembly-paths.json
  - id: 2port-can-routing-review
    title: 2port CAN paired routing
    file: exports/2port/can-routing-review.json
  - id: 2port-fabrication-profile-check
    title: 2port Local fabrication profile
    file: exports/2port/fabrication-profile-check.json
  - id: 4port-can-routing-review
    title: 4port CAN paired routing
    file: exports/4port/can-routing-review.json
  - id: 4port-fabrication-profile-check
    title: 4port Local fabrication profile
    file: exports/4port/fabrication-profile-check.json
  - id: 2port-prototype
    title: 2port prototype pads and power
    file: exports/2port/prototype-review.json
  - id: 4port-prototype
    title: 4port prototype pads and power
    file: exports/4port/prototype-review.json
  - id: 2port-lid-markings
    title: 2port engraved lettering clearances
    file: exports/2port/lid-markings-review.json
  - id: 4port-lid-markings
    title: 4port engraved lettering clearances
    file: exports/4port/lid-markings-review.json
  - id: 2port-lid-slicing
    title: 2port offline lid slicing
    file: exports/2port/lid-slicing-review.json
  - id: 4port-lid-slicing
    title: 4port offline lid slicing
    file: exports/4port/lid-slicing-review.json
  - id: inserts
    title: Heat-set insert joints (cad-agent inserts cad/joints.yaml)
    file: exports/inserts.json
