mvalancy/pcb-agx-thor-can-breakout/(commit log)

2026-10-26 Publish A0 Thor CAN adapters, keyed housings and source-bound design review
    [2port_base.3mf, 2port_base.step, 2port_base.stl, 2port_can_cables.stl, 2port_clamp.stl, 2port_female.stl, 2port_header.stl, 2port_hoods.stl]
2026-10-26 Treat generated CAD artifacts as binary review outputs
2026-10-26 Exclude local KiCad state by packaging only validated public files
2026-10-27 Restore root GitHub overview and prevent README precedence regressions
    [validate_release.py]
2026-10-27 Revise A1 CAN routing, enclosure identity and engineering documentation
    [2port_base.3mf, 2port_base.step, 2port_base.stl, 2port_can_cables.stl, 2port_clamp.stl, 2port_female.stl, 2port_header.stl, 2port_hoods.stl]
2026-10-27 Add prototype access, clear controls and reinforced mounting housings
    [2port_base.3mf, 2port_base.step, 2port_base.stl, 2port_clamp.stl, 2port_inserts.stl, 2port_legend_paint.stl, 2port_lid.3mf, 2port_lid.step]
2026-10-27 Add four broad corner mounts and adopt finer shared viewer zoom
    [2port_base.3mf, 2port_base.step, 2port_base.stl, 2port_legend_paint.stl, 2port_lid.3mf, 2port_lid.step, 4port_base.3mf, 4port_base.step]
2026-10-27 Enlarge lid lettering and validate engraved print details
    [2port_base.3mf, 2port_base.step, 2port_legend_paint.stl, 2port_lid.3mf, 2port_lid.step, 2port_lid.stl, 4port_base.3mf, 4port_base.step]
2026-11-03 README: open with an animated banner drawn from the two-port board
    The overview now leads with a <picture> (light and dark, unlinked) above
    the title. The banner is generated by tools/hero in mvalancy/mvalancy
    from hardware/2port/thor-2port.kicad_pcb: the outline is traced, the J47
    header and both DE9 ports drop on, the CAN0 and CAN1 pairs are laid from
    the header to their ports, and pulses run along each pair. CSS animation
    only; the final frame holds still under prefers-reduced-motion.
    write_readmes.py gains guides for docs/img and docs/img/hero, and the
    release manifest is re-recorded for the new files.
    Closes #6
2026-11-03 README banner: regenerate from mvalancy/mvalancy#5 at 2e5792b (review fixes)
    Same motif; the faint copper is chained into polylines (53,448 bytes per
    file) and the chip reads "termination jumpers". Release manifest
    re-recorded.
2026-11-03 README banner: alt text names the board and final frame; keep docs/img out of release packages (review)
    The alt text now gives the banner's tagline and what the still frame shows,
    not the motion. package_release.py leaves docs/img (the decorative banner)
    out of the PCB and housing ZIPs. Release manifest re-recorded.
2026-11-03 WIP: move to cad-agent v0.18.2, new module paths, PCB title block, export_step, insert joints
    Evidence is not regenerated yet; this commit is the input for the mechanical rebuild run.
    [thor-2port-B_Cu.gbl, thor-2port-B_Mask.gbs, thor-2port-B_Silkscreen.gbo, thor-2port-Edge_Cuts.gm1, thor-2port-F_Cu.gtl, thor-2port-F_Mask.gts, thor-2port-F_Paste.gtp, thor-2port-F_Silkscreen.gto]
2026-11-03 Record part stock, insert torque limits and lid ring exceptions
    - cad-agent.yaml: list the lids' engraved DE9 pin-number rings as hole
    exceptions (they are 0.4 mm deep artwork, not holes).
    - docs/manufacturing.md, release-checklist.md: part stock on 2026-11-03
    (the DE9 receptacle shows 0 at JLC and LCSC) and the A1 REVIEW Gerber
    revision.
    - ASSEMBLY.md: 0.14 N·m torque ceiling from cad-agent inserts.
    - references/toolchain.json: cad-agent v0.18.2.
    - .agents: lesson on hashing moved modules, not their shims.
2026-11-03 check_lid_slicing: say the slice now covers all seven printed parts
2026-11-03 Document the v0.18.2 pass: slicing, holes, overhangs, insert torque
    All seven printed parts slice (295 g, 9.9 h); the overhang screen and
    slicer agree the base clamp deck and lid engraving roofs print as
    bridges. Record the 0.14 N·m insert torque ceiling, the rejected snap-fit
    clamp, the new check commands and the housing checklist row.
2026-11-03 Regenerate evidence on cad-agent v0.18.2 (fleet job 122 on cpu-a)
    Housing exports, previews and the 3D view come from fleet job 122 on
    cpu-a at aac56d2; part volumes are unchanged. New hole-checks.json,
    overhang-screen.json and the three-plate 3MF. Slicing of all seven parts,
    the cad-agent report, folder READMEs and the release manifest are
    regenerated locally.
    [2port_base.3mf, 2port_base.step, 2port_base.stl, 2port_can_cables.stl, 2port_clamp.stl, 2port_female.stl, 2port_header.stl, 2port_hoods.stl]
2026-11-03 Review fixes: ribbon slot skin, title-block mirroring, insert and overhang text
    - cad/build.py: cut the ribbon slot through the base tongue's full height;
    the tongue rose 0.1 mm above the slot cut and left a skin the slicer
    drops but the STEP kept.
    - tools/apply_fab_rules.py: put the title block after any (paper ...)
    line and fail loudly if there is none; match parentheses and compare
    blocks by s-expression tokens, so quoted values are kept whole.
    - docs: washers lower the insert ceiling (0.092 N·m), they do not raise
    it; the snap-fit arm's margin, not a retention force; the counterbore
    overhangs and the clamp boss warning; four-port part counts.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
    [apply_fab_rules.py]
2026-11-03 Regenerate evidence after the slot fix (fleet job 123 on cpu-a)
    Housing exports, previews and the 3D view come from fleet job 123 on
    cpu-a at f7a2b7e: each base is 4.4 mm³ lighter (the slot skin), other
    volumes unchanged, every check passes. ERC/DRC (still zero), the
    routing, fabrication, prototype and electrical reviews, slicing, the
    report and the release manifest are regenerated.
    [2port_base.3mf, 2port_base.step, 2port_base.stl, 2port_legend_paint.stl, 4port_base.3mf, 4port_base.step, 4port_base.stl, 4port_legend_paint.stl]
2026-11-04 Loop the README banner
    Regenerated with mvalancy/mvalancy#6: the banner replays its intro, holds
    the finished frame for about 4 s, fades and builds again, so a visitor who
    scrolls to it late still sees it draw. Reduced motion still shows the
    finished frame.
